Timicasto/HeartRateMonitor/Tex/template_Report.pdf

# 光电心率计

指导教师：吴裕斌
班级：光电 2004 班
姓名：姚海舟∗
学号：U202014528
同组者：汪鑫书 李博函
联系电话：13720213247

2023 年 6 月 1 日

∗Solution chosen by Timicasto Index

1

目录 | 2

目录

1 技术指标 | 4
2 基本原理 | 5
3 方案论证 | 6
4 硬件电路设计 | 7
5 软件设计 | 9
6 测试报告 | 10
7 结论 | 12
8 免责声明 | 12
附录 A 附录 1 - PCB 原理图 | 14
附录 B 附录 2 - PCB 生产版图 | 15
附录 C 附录 3 - BOM 表 | 26

目录 | 3

摘要

基于光电容积描记术（PPG）的光学心率检测系统，该系统由发射器控 制模块，接收器模块，带通滤波模块和信号分析模块组成，脉搏信号依次通 过上述模块处理后得到最终精确的脉搏。

1 技术指标 | 4

## 1 技术指标

实时信号预处理，在每个脉搏产生后立刻可见心室收缩间隔时间，可用 于监测心率不齐等，可处理 30～260bpm 间的脉搏数据
带有谐波的 700kHz/1Ksps 波形显示与记录 一体化透明盖板，带有为提高光效率和采样精度设计的聚光透镜和变 向棱镜二合一的外形

2 基本原理 | 5

## 2 基本原理

本系统使用 PPG （光电容积描记术）完成脉搏信号量测，将光照射进 皮肤，当血流动力发生变化时，就会可预见地散射光。
氧合血红蛋白在可见光范围内有 550nm 和 600nm 两个吸收峰，使用 绿光 LED 将光射入皮肤，则光电二极管上流过的电流曲线即为血流动力的 变化曲线。
反射光强达最大值时即为此处皮肤中动脉搏动即心室收缩的时刻，因 为心率的定义为两次心室收缩的时间间隔，所以记录相邻的两次时刻并计 算其间隔即为此刻的心率

3 方案论证 | 6

## 3 方案论证

PPG 有两个关键的核心过程，就是信号的发射与采集，氧合血红蛋白 的吸收光谱在 400nm 呈现出最高的一个峰，在 550 和 600nm 上有次高的 两个峰。
因为只有在吸收峰上的光才会是被血红蛋白正确吸收，而 400nm 的 LED 灯又太过昏暗，于是这里选用了主波长为 540～560nm 的 LED 灯作 为发射源。
而光电二极管是可以把特定范围波长的光强转化为电流信号的器件，此 处选择可以响应 540～560nm 波长的光电二极管即可最好地接收反射的光 信号.
然而这里接受到的信号是比较微弱的电流信号，还需要使用跨阻放大 器将其转换为电压信号，并使用增益可变的放大器将电压信号放大，来适应 不同的皮肤透射率，不同环境光强，皮肤与传感器不同距离的使用场景。 放大得到的信号还含有皮肤等其它组织反射的恒定光，表现为直流分 量，和大量的被测皮肤运动产生的高频噪声，此处使用带通滤波器将其滤除 后将信号送入 STM32 的 12 位 ADC。
由于此系统需要处理最大达 260bpm 即 4.3Hz 的信号，则为了更好地 还原波形和更好的数据实时性，将 ADC 配置为 12bit 精度和 1Ksps 的采样 率，分别采样 10Hz 以上被滤除的信号和 4.3Hz 以上被滤除的信号，用于波 形显示和心率计算。
[1] [2]

4 硬件电路设计 | 7

## 4 硬件电路设计

对于主控 MCU 的选型，考虑到此系统的运算量不大，在成本和功耗的 考虑下选择了 STM32G0x0 低成本系列 MCU，得益于 G0 系列不需要晶振 的特点，也可以节省板上空间，而此系统中共需要调试接口，屏幕，可变增 益放大器，采集到的心率信号，LED 控制共五组 IO，则选择具有 20 引脚， 成本最低的的 FxP 封装。
由于所有的 IO 全部都是常用嵌入式接口或 GPIO，则选用 G0x0 中最 低端的型号 G030F6P 作为此系统的主控。
MCU 的供电部分，使用具有 3x3 QFN 小封装低成本的 TLV62130 构 造了 2.5MHz 的高效率开关电源输出系统 3.3V 供电，变换器的效率可达 0.89，且仅占用了 3x5mm 的板面积，可输出最大 3A 的电流。 用户界面使用了一块 1.44in，具有 128x128 分辨率，262K 色的普通 TFT-LCD 屏幕和 50cd/m² 的 WLED 背光，配合 ST7735S 控制芯片，使 用五个 IO 接口，分别传输显示数据，显示时钟，重置信号，命令/数据标志 信号和背光信号。
经过对分销商平台上所有 LED 的筛选，最终选择了两颗来自 Vishay 的 VLMTG41S2U1-GS08 ，这颗 LED 使用 InGaN 技术部分攻克了绿光 LED 的亮度难题，在 3.2V 的正向电压下达到了至少 560mcd 的亮度，且波 长偏离不超过 +-15nm。
光电二极管的选型遇到了一点难题，绝大多数光电二极管是设计用来 接收红外遥控信号的，所以完全不会响应可见光。
经历了海量的搜索后，仍然是在 Vishay 找到了我们想要的东西：VEMD5510C， 它的响应峰值波长刚好为 550nm，只响应 440～700nm 之间的光，完全符 合本系统的波长需要。
因为 VEMD5510C 只有 0.2mm 厚，而我们的 LED 却是标准的 3528 封装，有 1.75mm 厚，于是我们把光电二极管夹在了两颗 LED 之间，并在 上面加上了一体式的聚光和变向棱镜。
放大器的部分，因为心率信号的带宽很低，所以为成本考虑选择了双 路 LM2904 运算放大器，并使用 TPS60403 电荷泵作为负压源，使用三颗 LM2904 构造起了跨阻放大器，可变增益放大器和后级的带通滤波器。 VEMD5510C 在 1000 lx 下有 10uA 的电流，于是我们采用了增益为 5dB 的跨阻放大器，将 0～10uA 的信号转换至 0～2.5V，让可变增益放大 器具有更大的操作空间。
在设计可变增益放大器时再次遇到了难点。
市面上的 PGA 芯片都达到了动辄百元的高价，并且增益配置也不够自

4 硬件电路设计 | 8

由，于是我们想到了使用数字电位器作为普通正增益运算放大器的反馈电 阻，本来以为数字电位器不是设计用于做这样的事情的，结果意外地真的找 到了可以用于这种用途的数字电位器：使用 I2C 协议的 AD5272。
于是 PGA 的设计顺理成章，使用 AD5272BCPZ-20 设计了 0～20 倍 放大倍数可变的放大器。
最后一个难题就是滤波器了。
本系统中的有效信号频率介于 0.4～4.3Hz 之间，我们选用了增益曲线 较平缓的二级 Butterworth 滤波器作为高通滤波器，滤除 0.4Hz 以下的信 号，但是这里第二级反馈系统的电容太大了，数值也太离谱了。 先是到了离谱的 80uF，调低了阻断频带衰减率后变成了 20.5uF 和 16uF，取 E6 系列电容的近似值则为 33uF 和 15uF，勉勉强强找到了尺寸 为 0805 的 MLCC 电容，免除了使用大号电解电容的麻烦。 然后用阻断频带为 10Hz 和 4.3Hz 的低通滤波器，分别输出用于波形显 示和用于心率计算的信号给 STM32 的 ADC1 CH0 和 CH1。
整个 PCB 的板框尺寸与屏幕的尺寸一致，使用四个 M2 螺丝和屏幕固 定为一体，其它所有电阻电容均选用 0603 封装的型号。 至此完成了上面的电路原理设计和布局布线后，硬件的设计就全部完 成了

5 软件设计 | 9

## 5 软件设计

软件部分使用现代 C/C++ 语言（C23/C++23），引入 STM32 HAL 库与硬件交互，并完全符合现代 OOP 编程范式。
所有硬件初始化代码使用 STM32CubeMX 生成，构建系统文件基于 STM32CubeMX 生成的 Makefile 修改，使其支持 C++ 的编译和链接。 数据采集部分，我们初始化了一个每秒溢出 1000 次的 Timer，用 TRGO 事件触发 ADC 的采集，每完成一次采集触发中断后开始处理数据，将电压 幅值数据送入心率算法对象。
心率算法类接受电压幅值作为输入，使用一次心率周期进行电压范围 校准后，钳制在校准数据峰值三分之二以上的部分为有效峰值数据区域，同 时维护当前周期最大幅值和其对应的绝对采样次数，当下一次幅值进入有 效峰值窗口时将当前数据记录为上一周期与当前周期作差后计算时间间隔 对应的心率。
当两个周期的数据均有效，并成功计算出心率后，在主循环中将其发送 至屏幕显示。

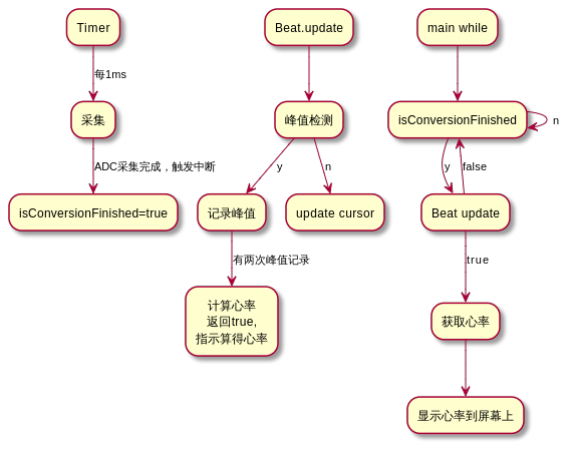
[picture p5: figure]

图 1: 软件设计流程图

6 测试报告 | 10

## 6 测试报告


图 2: 电源纹波测试：5.78mV Peak-to-Peak

6 测试报告 | 11


图 3: 原始电平波形，Y 轴单位长度 0.8mV

7 结论 | 12

## 7 结论

本课程设计报告详细阐述了一个基于光电容积描记术（PPG）的光学心 率检测系统的设计和实现。系统由发射器控制模块，接收器模块，带通滤波 模块和信号分析模块组成，能够实时处理和显示 30 260bpm 间的脉搏数据。 在硬件和软件设计部分，我们选择了 STM32G0x0 低成本系列 MCU 作 为主控，使用了现代 C/C++ 语言（C23/C++23），引入 STM32 HAL 库 与硬件交互。测试结果显示，该系统能够准确地测量和显示心率数据.

## 8 免责声明

此设计不可用于生命攸关的医疗设备，除非已由双方授权官员签署了 专门管控此类使用情况的特殊合同
使用风险自负
This design may not used in life-critical medical equipment unless authorized officers of the parties have executed a special contract specifically governing such use.
USE AT YOUR OWN RISK.

参考文献 | 13

## 参考文献

[1] Doug Mercer. Activity: Heart Rate Monitor Circuit[R].Analog Wiki, 14 May 2022 (https://wiki.analog.com/university/courses/alm1k/alm-lab-heart-rate-mon)
[2] Swagatam. Heart Rate Monitor Circuit[J]. Homemade Circuit Projects, October 18, 2019 (https://www.homemade-circuits.com/heart-rate-monitor-alarm-circuit/)

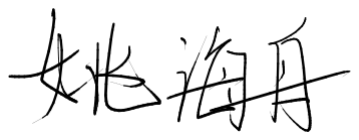
[picture p6: figure]

## A 附录 1 - PCB 原理图

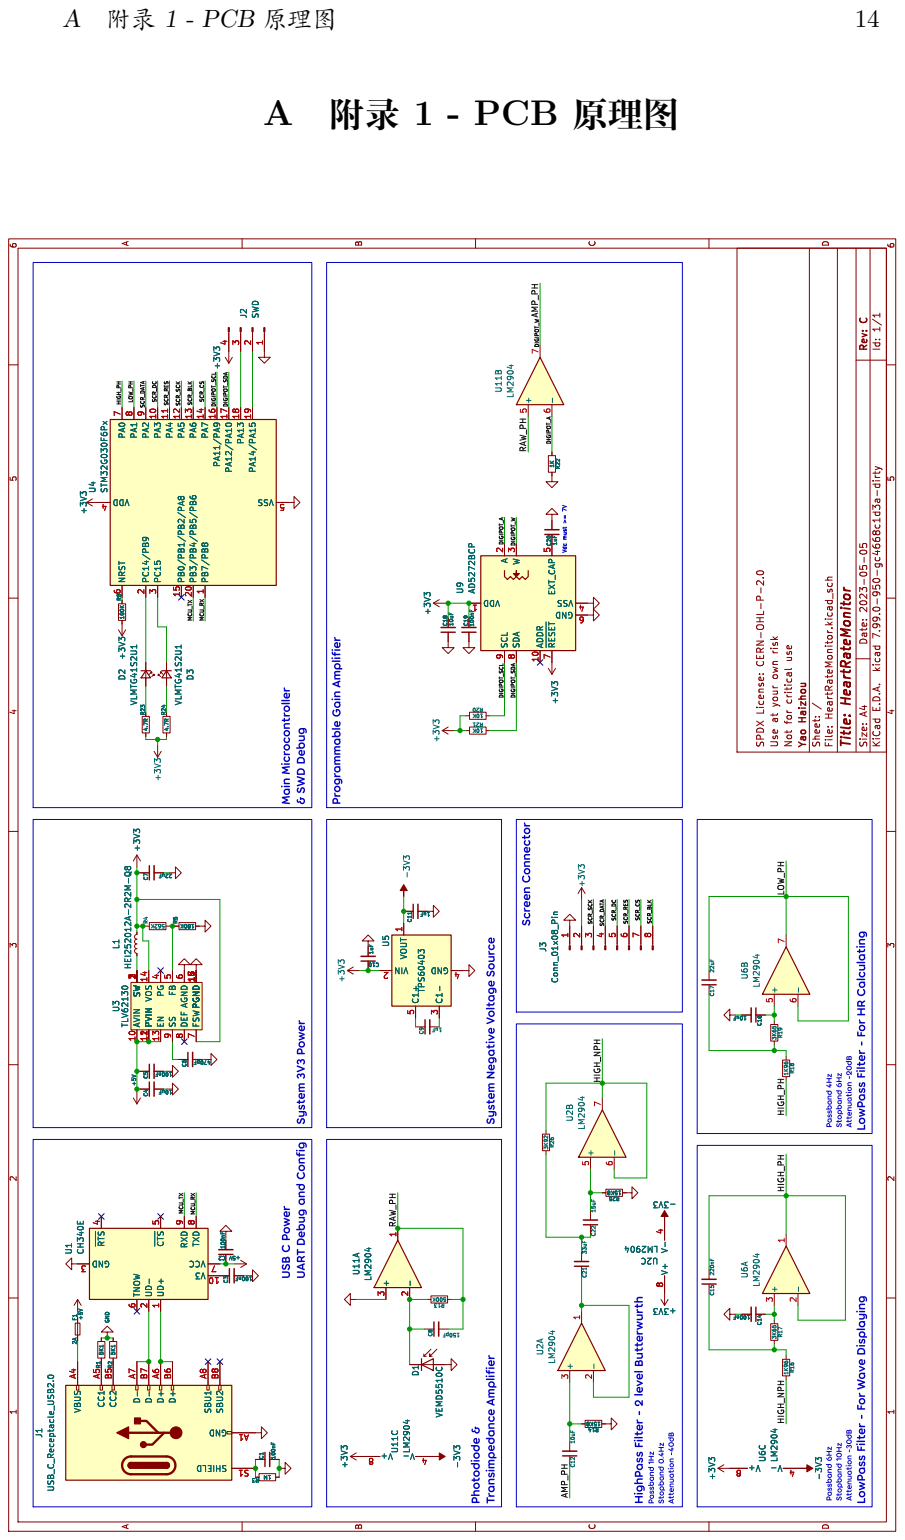
[picture p7: page 14]

D Date: 2023-05-05 KiCad E.D.A. kicad 7.99.0-950-gc4668c1d3a-dirty Rev: C Size: A4

Id: 1/1 Title: HeartRateMonitor File: HeartRateMonitor.kicad_sch Sheet: / Yao Haizhou Not for critical use Use at your own risk SPDX License: CERN-OHL-P-2.0

Vdc must >= 7V System Negative Voltage Source

100nF R5180K C7 22uF U3 TLV62130SW 1 AVIN 10 PVIN 112 EN 13 VOS 14 PGND 1567 SW 23 PG 4 FB 5 AGND 6 FSW 7 DEF 8 SS 9 +3V3

R23 4.7R R4562K SW 1 AVIN 10 PVIN 112 EN 13 VOS 14 PGND 1567 SW 23 PG 4 FB 5 AGND 6 FSW 7 DEF 8 SS 9 U3 TLV62130 +3V3 +3V3 VOUT 1 VIN

HIGH_PH LowPass Filter - For HRCalculating

System 3V3 Power Passband 6Hz Stopband 10Hz Attenuation -30dB

Transimpedance Amplifier Passband 4Hz Stopband 6Hz Attenuation -20dB USBC Power

Passband 1Hz Stopband 0.4Hz Attenuation -40dB HighPass Filter - 2 level Butterwurth+3V3 -3V3U2C LM2904 V- 4 V+ 8 R25 15K8 +5V C4 10uF C5 100nF C2 +5V

+5V GND U1 CH340E UD+ 1 V3 10 UD- 2 GND

LowPass Filter - For Wave Displaying

## B 附录 2 - PCB 生产版图

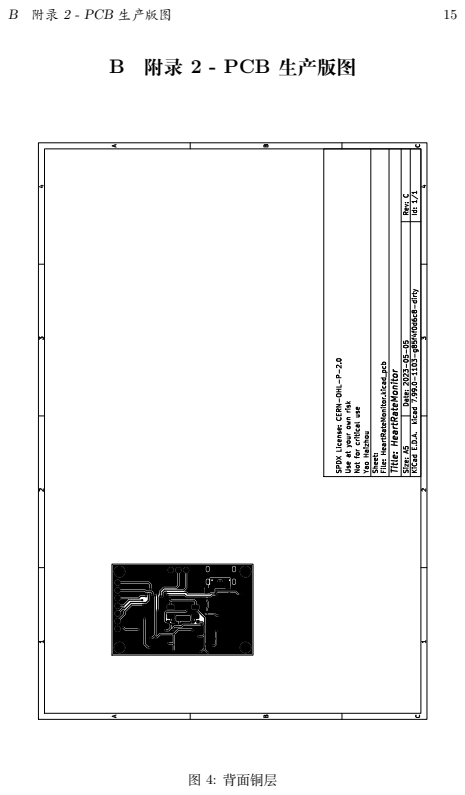
[picture p8: page 15]
B 附录 2 - PCB 生产版图; 图 4: 背面铜层

BC Date: 2023-05-05 KiCad E.D.A. kicad 7.99.0-1103-g85f4f0d6c8-dirty Rev: C Size: A5

Id: 1/1 Title: HeartRateMonitor File: HeartRateMonitor.kicad_pcb Yao Sheet:Haizhou Not for critical use Use at your own risk SPDX License: CERN-OHL-P-2.0

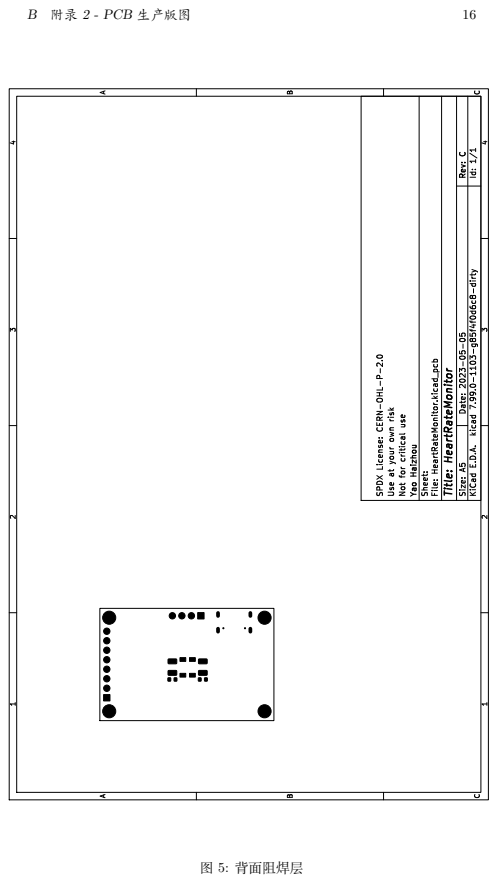
[picture p9: page 16]
B 附录 2 - PCB 生产版图; 图 5: 背面阻焊层

BC Date: 2023-05-05 KiCad E.D.A. kicad 7.99.0-1103-g85f4f0d6c8-dirty Rev: C Size: A5

Id: 1/1 Title: HeartRateMonitor File: HeartRateMonitor.kicad_pcb Yao Sheet:Haizhou Not for critical use Use at your own risk SPDX License: CERN-OHL-P-2.0

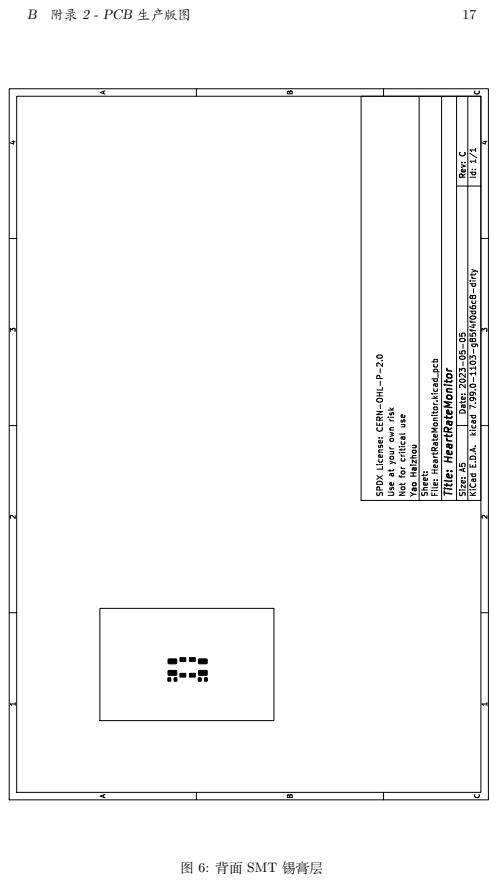
[picture p10: page 17]
B 附录 2 - PCB 生产版图

BC Date: 2023-05-05 KiCad E.D.A. kicad 7.99.0-1103-g85f4f0d6c8-dirty Rev: C Size: A5

Id: 1/1 Title: HeartRateMonitor File: HeartRateMonitor.kicad_pcb Yao Sheet:Haizhou Not for critical use Use at your own risk SPDX License: CERN-OHL-P-2.0

图 6: 背面 SMT 锡膏层

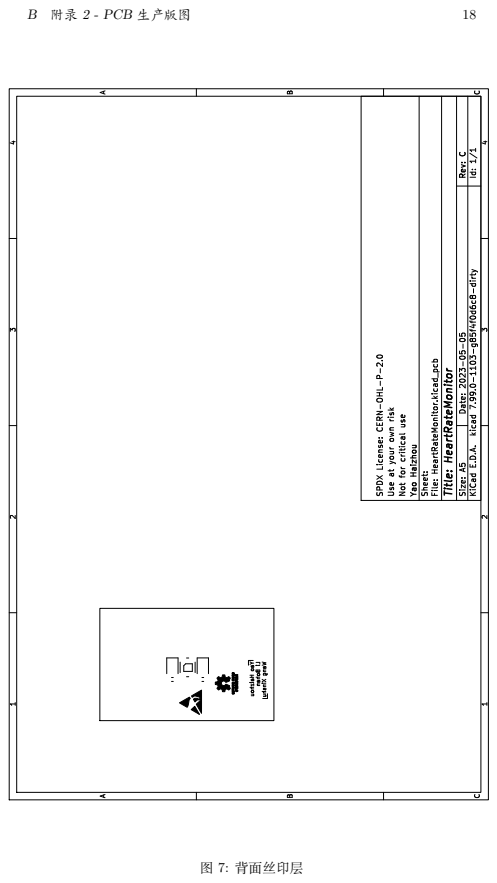
[picture p11: page 18]
B 附录 2 - PCB 生产版图; Yao Haizhou; 图 7: 背面丝印层

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

Li Bohan Wang Xinshu

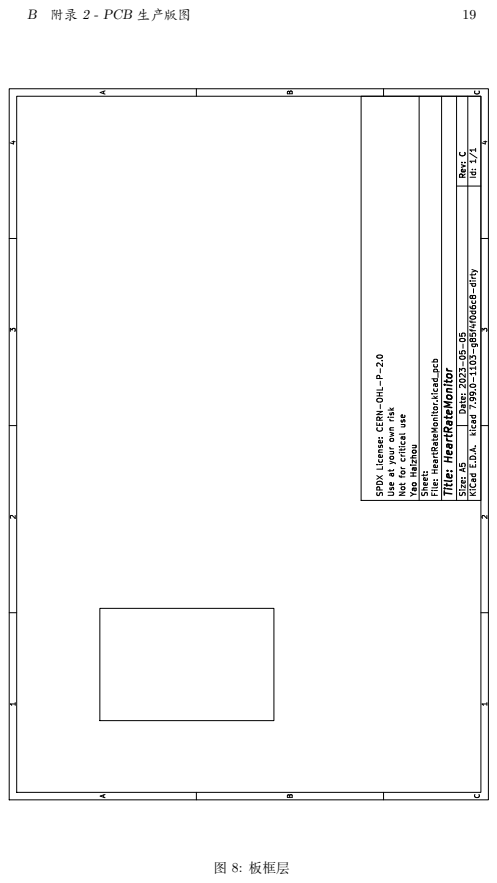
[picture p12: page 19]
B 附录 2 - PCB 生产版图; 图 8: 板框层

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

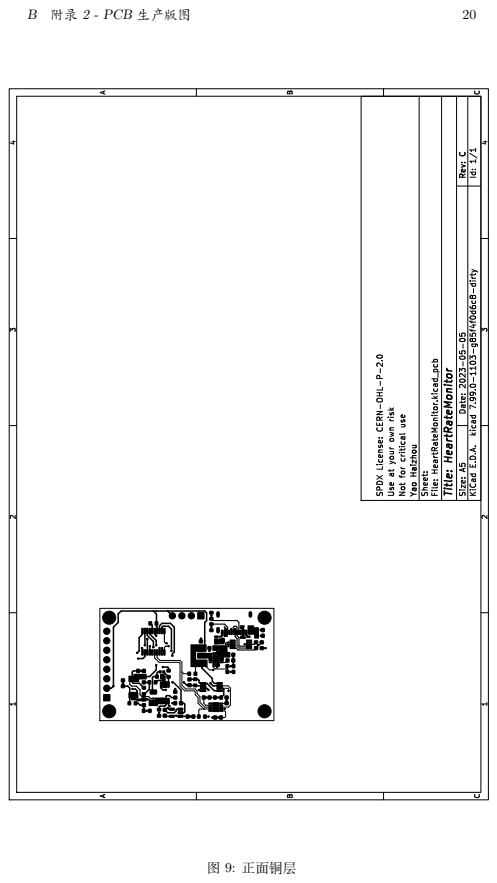
[picture p13: page 20]
B 附录 2 - PCB 生产版图; 图 9: 正面铜层

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

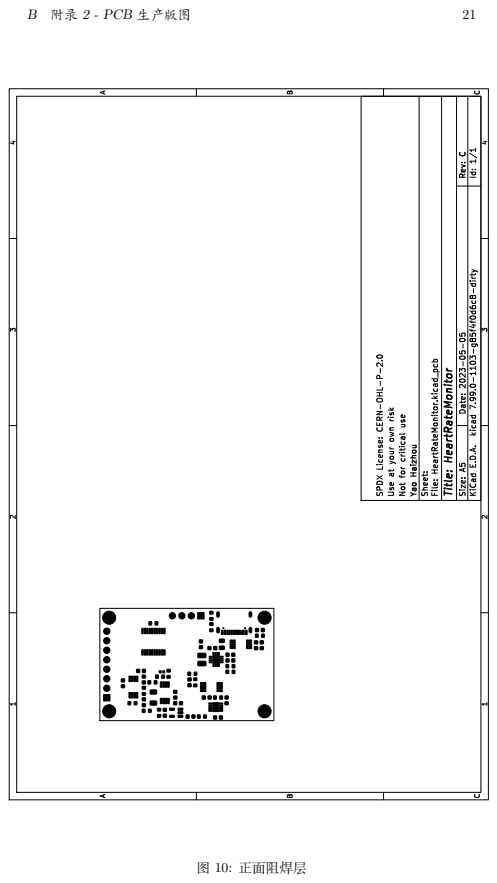
[picture p14: page 21]
B 附录 2 - PCB 生产版图; 图 10: 正面阻焊层

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

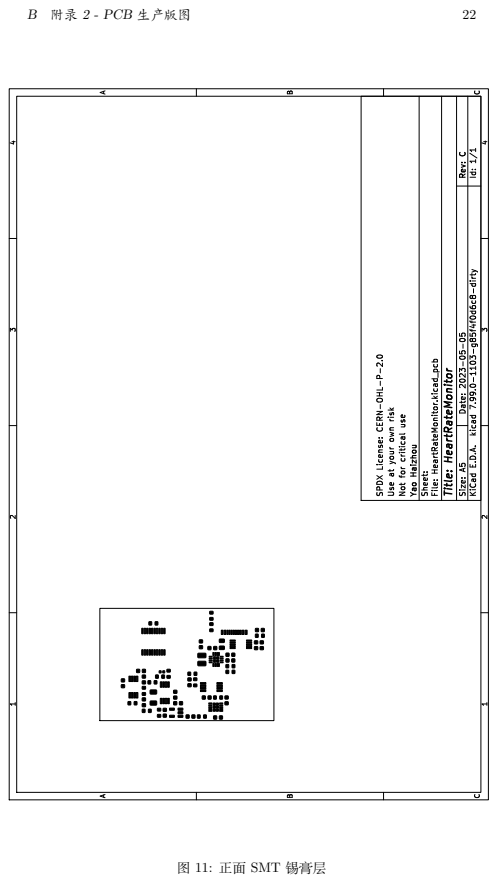
[picture p15: page 22]
B 附录 2 - PCB 生产版图

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

图 11: 正面 SMT 锡膏层

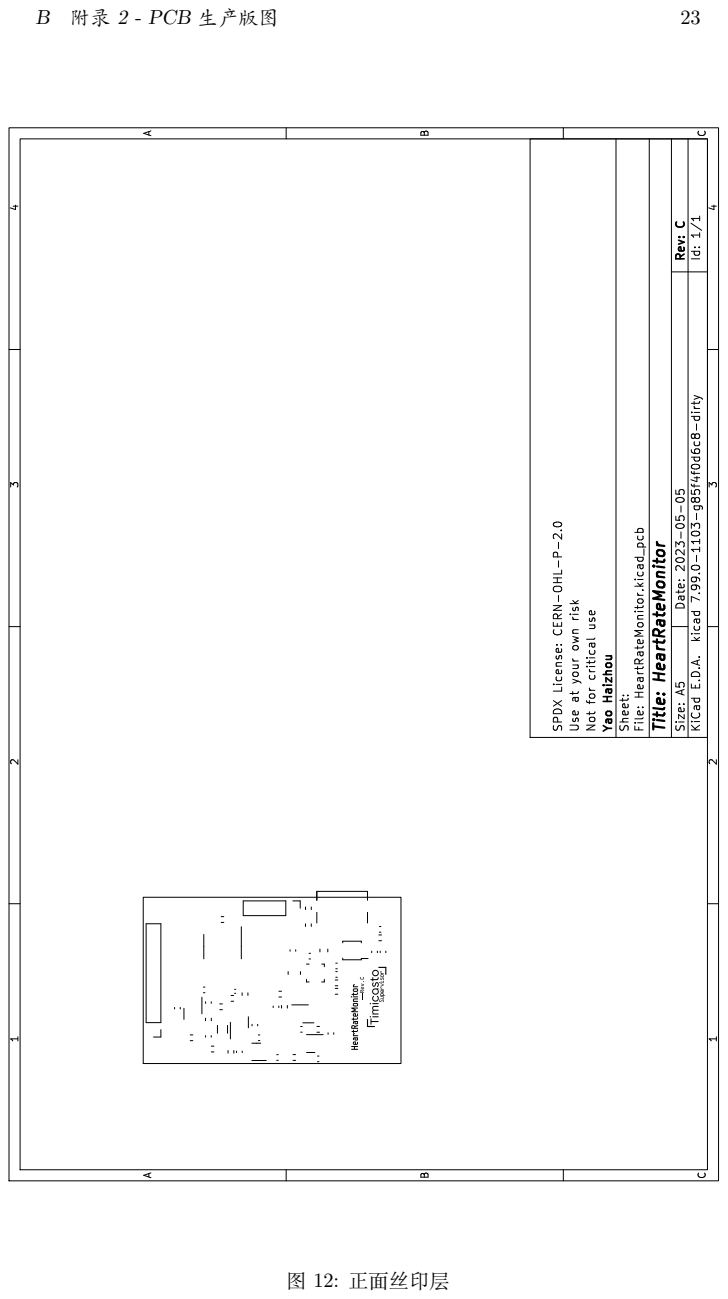
[picture p16: page 23]
B 附录 2 - PCB 生产版图; Supervisor Timicasto; HeartRateMonitor; 图 12: 正面丝印层

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

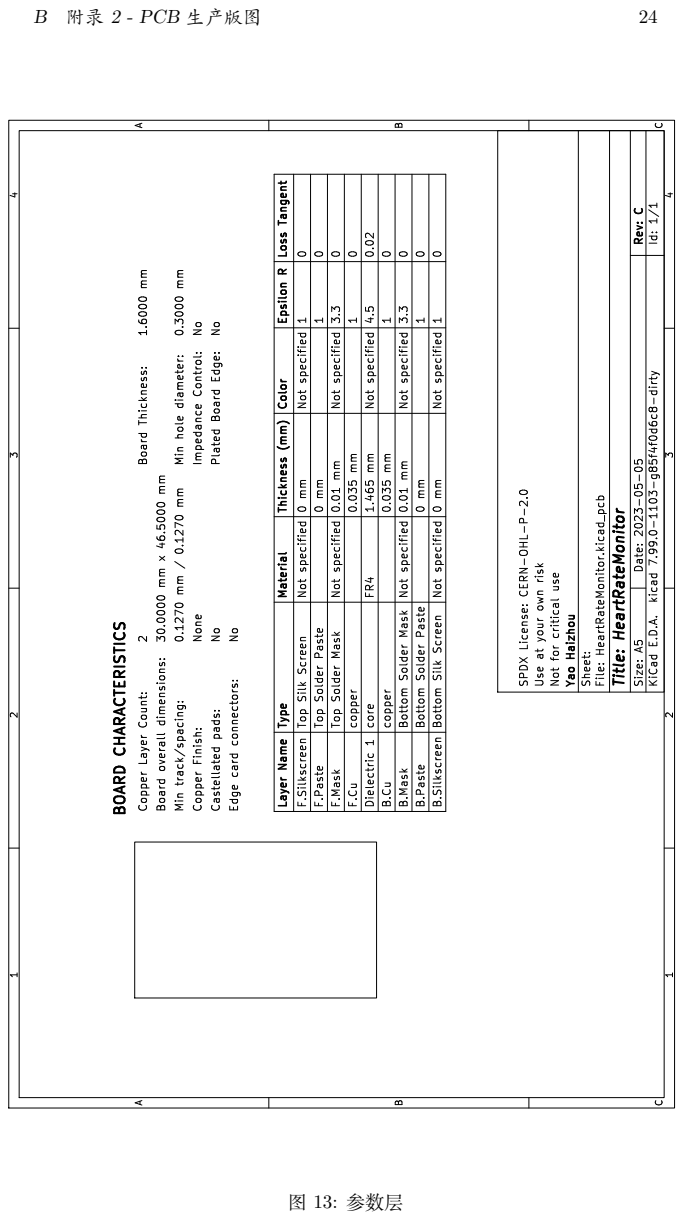
[picture p17: page 24]
B 附录 2 - PCB 生产版图; Not specified; 0 Top; copperSilk Screen; core; 0 Not specified; Color No; 图 13: 参数层

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

Loss Tangent Bottom Solder Paste

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

Dielectric 1 Min track/spacing: 4.5 Material 0.02 Not specified

0 Board overall dimensions: 0 mm

0 F.Cu Castellated pads:

0 Not specified F.Silkscreen Top Solder Mask Thickness (mm) Not specified

1 Not specified B.Silkscreen Epsilon R

Impedance Control: Bottom Solder Mask 1.6000 mm

3.3 Copper Finish: Min hole diameter: copper 0.3000 mm

1 Board Thickness: Bottom Silk Screen 0 mm

Edge card connectors: 1 None

Layer Name No

F.Mask Plated Board Edge: B.Mask 0.035 mm

0.035 mm BOARD CHARACTERISTICS

Copper Layer Count: Not specified F.Paste

Not specified Not specified B.Paste Type

Top Solder Paste

C 附录 3 - BOM 表 | 25

## C 附录 3 - BOM 表

Ref | Qnty | Value | Cmp name
C1 C2 C3 C5 C14 C19 | 6 | 100nF | TCC0603X7R104M160CT
C4 C12 C16 C18 | 4 | 10uF | CL10A106MQ8NNNC
C6 | 1 | 470pF | CC0603KRX7R9BB471
C7 C17 | 2 | 22uF | GRM188R61A226ME15D
C8 | 1 | 150pF | TCC0603X7R151K500CT
C9 C10 C11 C20 | 4 | 1uF | CL10A105KO8NNNC
C15 | 1 | 220nF | CS1608Y5V224Z160NRB
C21 | 1 | 33uF | C3216X5R1A336MTJ00N
C22 | 1 | 15uF | GRM155R60J156ME05D
D1 | 1 | VEMD5510C | VEMD5510C
D2 D3 | 2 | VLMTG41S2U1 | VLMTG41S2U1
F1 | 1 | 2A | SMD0805-100C-12V
J1 | 1 | USB-C-Receptacle-USB2.0 | USB-TYPE-C-019
J2 | 1 | SWD | Conn-01x04-Pin
J3 | 1 | Conn-01x08-Pin | 22850108ANG1SYA01
L1 | 1 | HEI252012A-2R2M-Q8 | HEI252012A-2R2M-Q8
R1 R2 | 2 | 5K1 | SCR0603F5K1
R3 | 1 | 1M | SC0603F1004F2BNRH
R4 | 1 | 562K | FRC0603F5623TS
R5 | 1 | 180K | SCR0603F180K
R8 | 1 | 100K | SCR0603F100K
R13 | 1 | 500K | ARG03BTC5003N
R14 R25 | 2 | 15K8 | FRC0603F1582TS
R16 R18 | 2 | 1K96 | FRC0603F1961TS
R17 R19 | 2 | 3K65 | FRC0603F3651TS
R20 R21 | 2 | 10K | SC0603F1002F2BNRH
R22 | 1 | 1K | 0603WAF1001T5E
R23 R24 | 2 | 4.7R | FRC0603F4R70TS
R26 | 1 | 3K92 | 0603WAF3921T5E
U1 | 1 | CH340E | CH340E
U2 U6 U11 | 3 | LM2904 | LM2904DGKR
U3 | 1 | TLV62130 | TLV62130RGTR
U4 | 1 | STM32G030F6Px | STM32G030F6P6
U5 | 1 | TPS60403 | TPS60403DBVR
U9 | 1 | AD5272BCP | AD5272BCPZ-20
