Timicasto/HeartRateMonitor/Tex/truetable.tex

\documentclass[a4paper]{ctexart}
\usepackage{CJK}
\usepackage{graphicx}
\usepackage{longtable}
\usepackage{float}
\usepackage{subfigure}
\usepackage{hyperref}
\begin{document}

	\newpage
	\begin{longtable}{p{1cm}|p{2cm}|p{2cm}|p{2cm}|P{2cm}|p{2cm}}
		采样次数 & 上一次心搏的电平峰值 & 上一次心搏时间 & 本次心搏峰值 & 本次心搏时间 & 两次心搏间隔 \\
		\hline
		1&0&0&0&0&0\\
		2&0&0&0&1&0\\
		3&0&0&0&2&0\\
		4&0&0&0&3&0\\
		5&0&0&0&4&0\\
		6&0&0&0&5&0\\
		7&0&0&0&6&0\\
		8&0&0&0&7&0\\
		9&0&0&0&8&0\\
		10&0&0&0&9&0\\
		11&0&0&0&10&0\\
		12&0&0&0&11&0\\
		13&0&0&0&12&0\\
		14&0&0&0&13&0\\
		15&0&0&0&14&0\\
		16&0&0&0&15&0\\
		17&0&0&0&16&0\\
		18&0&0&0&16&0\\
		19&0&0&0&16&0\\
		20&0&0&0&16&0\\
		21&0&0&0&16&0\\
		22&0&0&0&16&0\\
		23&0&0&0&16&0\\
		24&0&0&0&16&0\\
		25&0&0&0&16&0\\
		26&0&0&0&16&0\\
		27&0&0&0&16&0\\
		28&0&0&0&16&0\\
		29&0&0&0&16&0\\
		30&0&0&0&16&0\\
		31&0&0&0&16&0\\
		32&0&0&0&16&0\\
		33&0&0&0&16&0\\
		34&0&0&0&16&0\\
		35&0&0&0&16&0\\
		36&0&0&0&16&0\\
		37&0&0&0&16&0\\
		38&0&0&0&16&0\\
		39&0&0&0&16&0\\
		40&0&0&0&16&0\\
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
		
		\caption{上图波形输入算法的真值表}
	\end{longtable}
\end{document}
