Timicasto/HeartRateMonitor/Tex/truetable.pdf

1

采 样
次数

上一次心搏
的电平峰值

上一次心搏
时间

本次心搏峰
值

本次心搏时间 两次心搏间隔

1 | 0 | 0 | 0 | 0 | 0
2 | 0 | 0 | 0 | 1 | 0
3 | 0 | 0 | 0 | 2 | 0
4 | 0 | 0 | 0 | 3 | 0
5 | 0 | 0 | 0 | 4 | 0
6 | 0 | 0 | 0 | 5 | 0
7 | 0 | 0 | 0 | 6 | 0
8 | 0 | 0 | 0 | 7 | 0
9 | 0 | 0 | 0 | 8 | 0
10 | 0 | 0 | 0 | 9 | 0
11 | 0 | 0 | 0 | 10 | 0
12 | 0 | 0 | 0 | 11 | 0
13 | 0 | 0 | 0 | 12 | 0
14 | 0 | 0 | 0 | 13 | 0
15 | 0 | 0 | 0 | 14 | 0
16 | 0 | 0 | 0 | 15 | 0
17 | 0 | 0 | 0 | 16 | 0
18 | 0 | 0 | 0 | 16 | 0
19 | 0 | 0 | 0 | 16 | 0
20 | 0 | 0 | 0 | 16 | 0
21 | 0 | 0 | 0 | 16 | 0
22 | 0 | 0 | 0 | 16 | 0
23 | 0 | 0 | 0 | 16 | 0
24 | 0 | 0 | 0 | 16 | 0
25 | 0 | 0 | 0 | 16 | 0
26 | 0 | 0 | 0 | 16 | 0
27 | 0 | 0 | 0 | 16 | 0
28 | 0 | 0 | 0 | 16 | 0
29 | 0 | 0 | 0 | 16 | 0
30 | 0 | 0 | 0 | 16 | 0
31 | 0 | 0 | 0 | 16 | 0
32 | 0 | 0 | 0 | 16 | 0
33 | 0 | 0 | 0 | 16 | 0
34 | 0 | 0 | 0 | 16 | 0

2

35

0

0

| 0 | 16

0
36

0

0 | 0 | 16

0
37

0

0 | 0 | 16

0
38

0

0 | 0 | 16

0
39

0

0 | 0 | 16

0
40

0

0 | 0 | 16

0
41

0

0 | 0 | 16

0
42

0

0 | 0 | 16

0
43

0

0 | 0 | 16

0
44

0

0 | 0 | 16

0
45

0

0 | 0 | 16

0
46

0

0 | 0 | 16

0
47

0

0 | 0 | 16

0
48

0

0 | 0 | 16

0
49

0

0 | 0 | 16

0
50

0

0 | 0 | 16

0
51

0

0 | 0 | 16

0
52

0

0 | 0 | 16

0
53

0

0 | 0 | 16

0
54

0

0 | 0 | 16

0
55

0

0 | 0 | 16

0
56

0

0 | 0 | 16

0
57

0

0 | 0 | 16

0
58

0

0 | 0 | 16

0
59

0

0 | 0 | 16
0
60

0

0 | 41 | 59

0
61

0

0 | 41 | 59

0
62

0

0 | 41 | 59

0
63

0

0 | 41 | 59

0
64

0

0 | 41 | 59

0
65

0
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
1818 | 0 | 1534 | 0 | 1534 | 684
1819 | 0 | 1534 | 0 | 1534 | 684
1820 | 0 | 1534 | 0 | 1534 | 684
1821 | 0 | 1534 | 0 | 1534 | 684
1822 | 0 | 1534 | 0 | 1534 | 684
1823 | 0 | 1534 | 0 | 1534 | 684
1824 | 0 | 1534 | 0 | 1534 | 684
1825 | 0 | 1534 | 0 | 1534 | 684
表 1: 上图波形输入算法的真值表
