Timicasto/HeartRateMonitor/Shell/shell-PartCap.stl

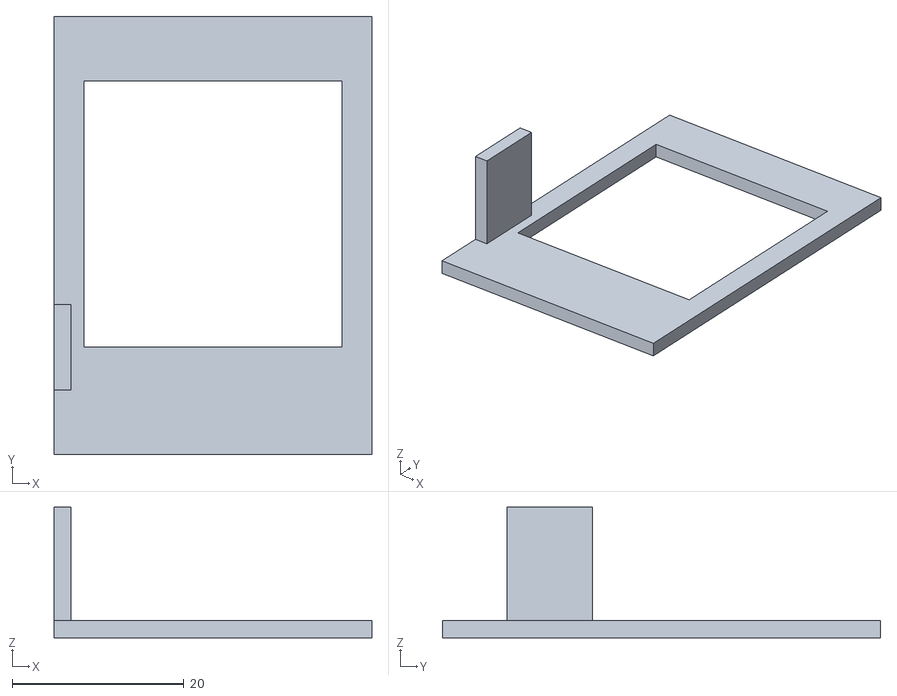
[picture p18: CAD file, 2023-05-20]
Shell/shell-PartCap.stl
37.0 x 51.0 x 15.2
