Timicasto/HeartRateMonitor/Shell/shell-PartBody.stl

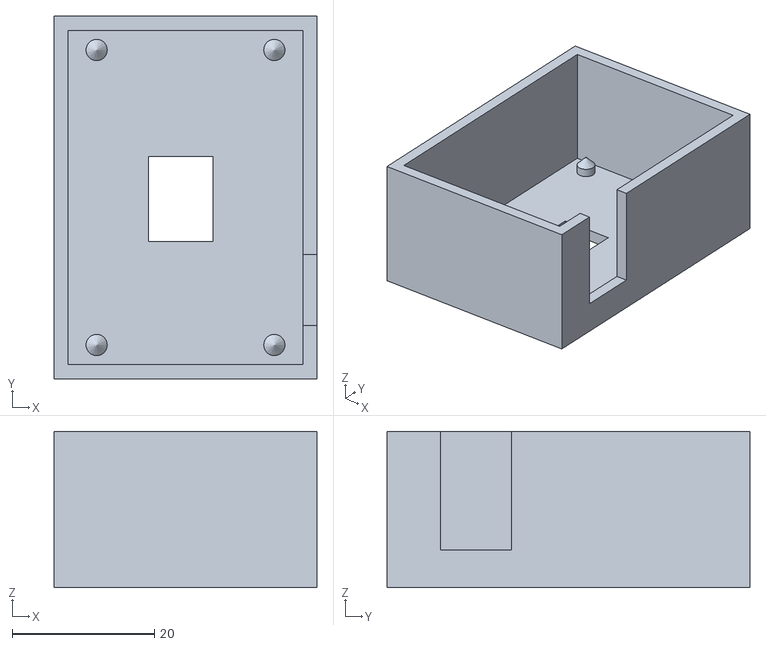
[picture p19: CAD file, 2023-05-20]
Shell/shell-PartBody.stl
37.0 x 51.0 x 22.0
