Timicasto/HeartRateMonitor/Shell/shell.FCStd

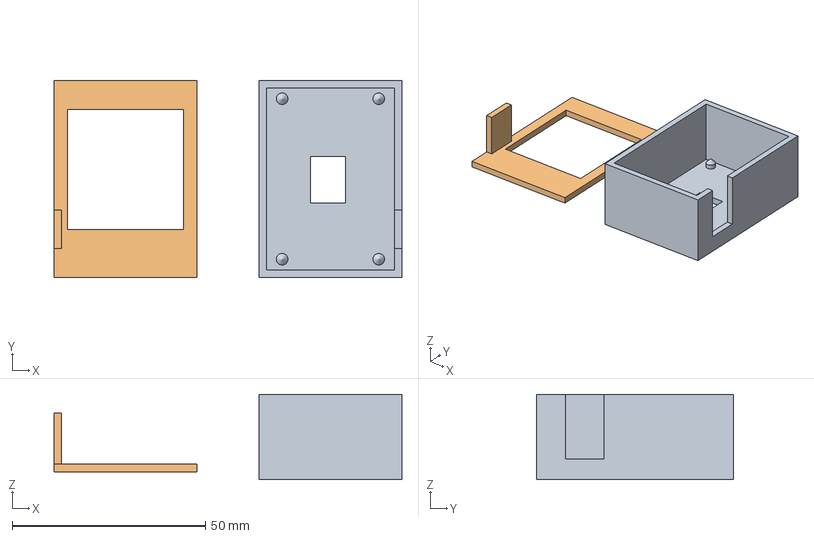
[picture p20: CAD file, 2023-05-20]
Shell/shell.FCStd
90.0 x 51.0 x 22.0 mm
