Timicasto/HeartRateMonitor/PDF/HeartRateMonitor-User_1.pdf

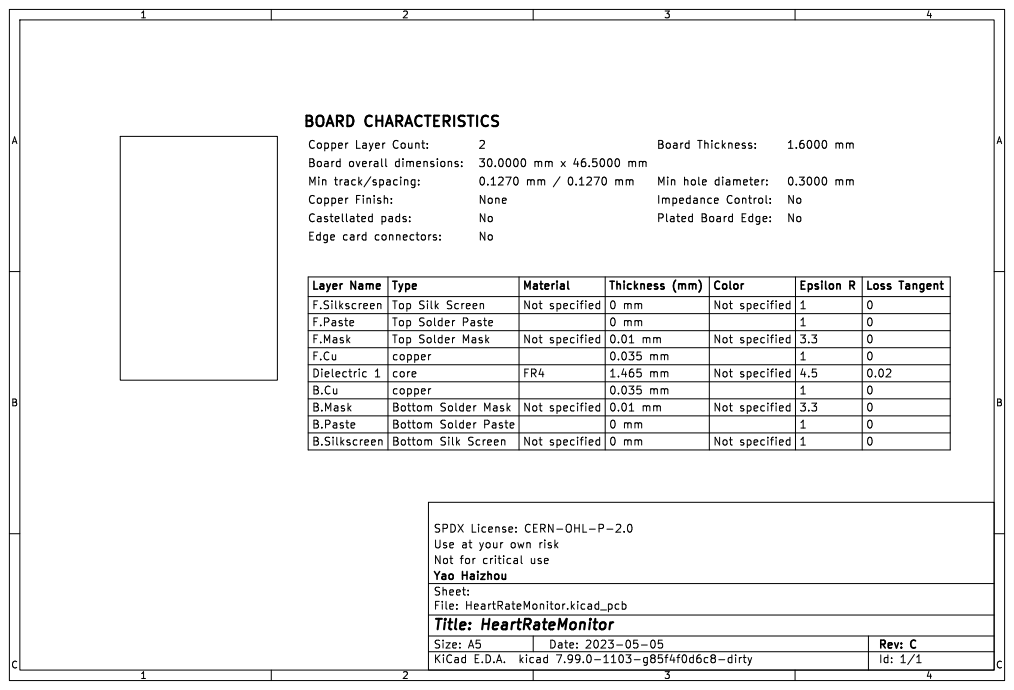
[picture p21: page 1]

F.Mask | pads: | | 0.035 mm | Plated Board | Edge: B.Mask | 3.3 No B.Cu Epsilon R | 0 F.Cu Castellated

Not specified Not specified B.Paste

core Type copper Top Silk Top Solder Paste | Screen | | | | | 1 | 0

0.01 mm | Loss Tangent Bottom Solder Paste 0

0.01 | mm | Not specified | 0

0 mm | Not specified | 1 B.Silkscreen | 0
