Timicasto/HeartRateMonitor/Tex/schem.pdf

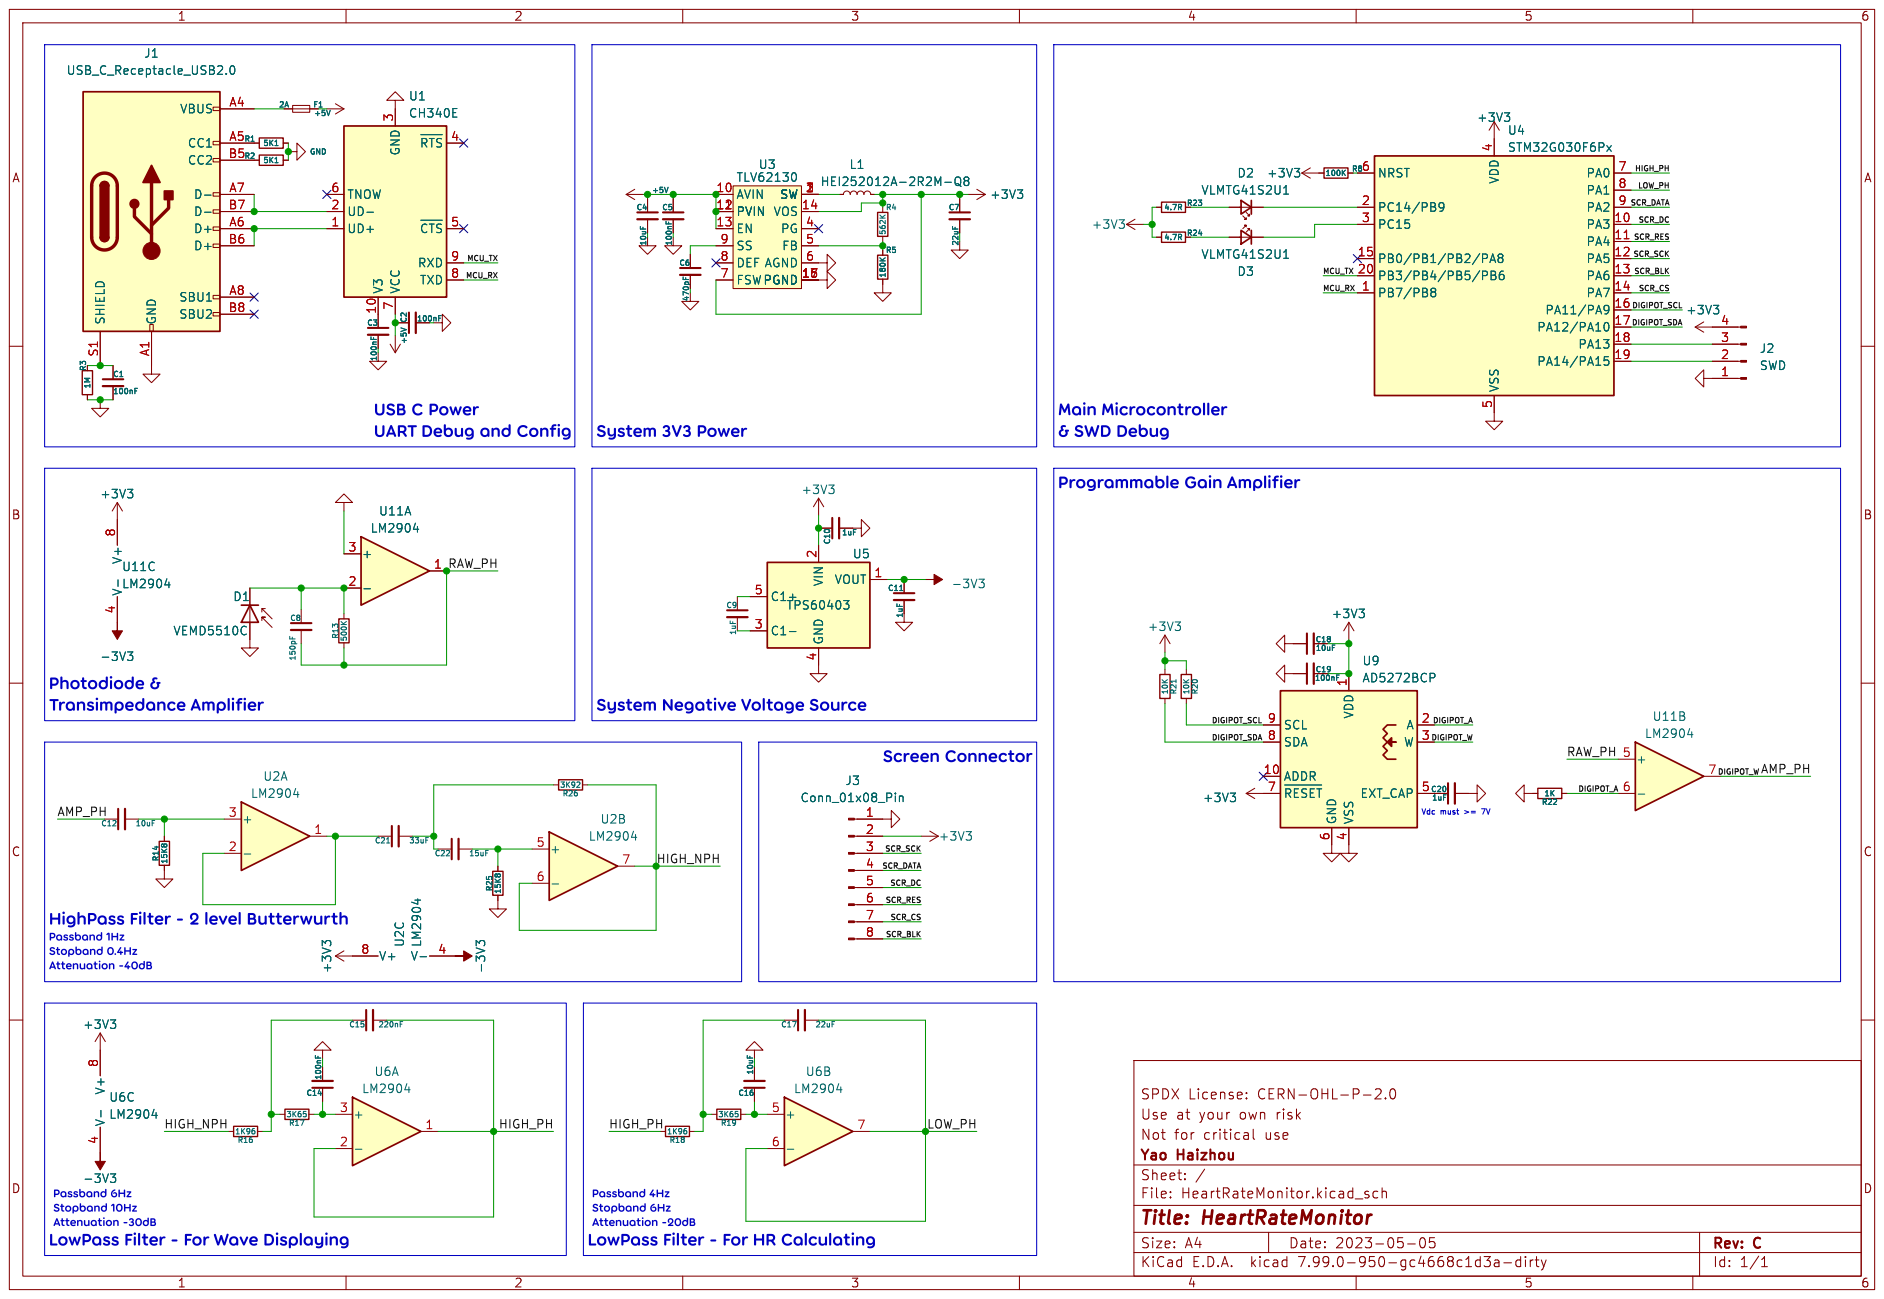
[picture p22: page 1]

3 ~{RTS}4 ~{CTS}5 TNOW 6 VCC

System 3V3 Power Passband 6Hz Stopband 10Hz Attenuation -30dB

Vdc must >= 7V System Negative Voltage Source

LowPass Filter - For Wave Displaying
