Timicasto/HeartRateMonitor/PDF/HeartRateMonitor-B_Cu.pdf

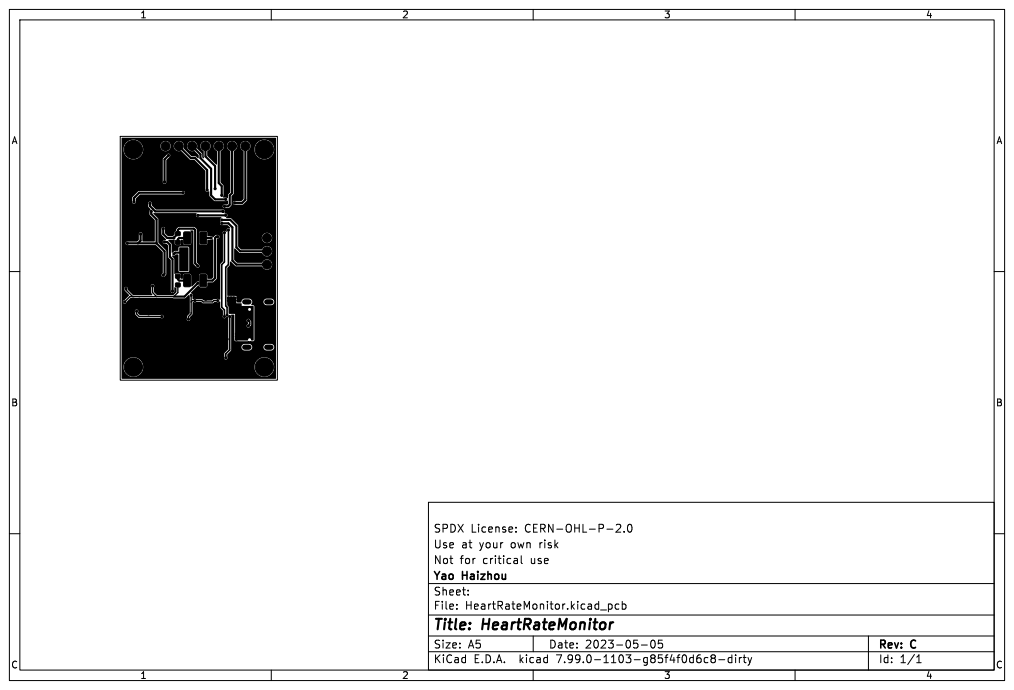
[picture p23: page 1]
