Timicasto/HeartRateMonitor/PDF/HeartRateMonitor-B_Mask.pdf

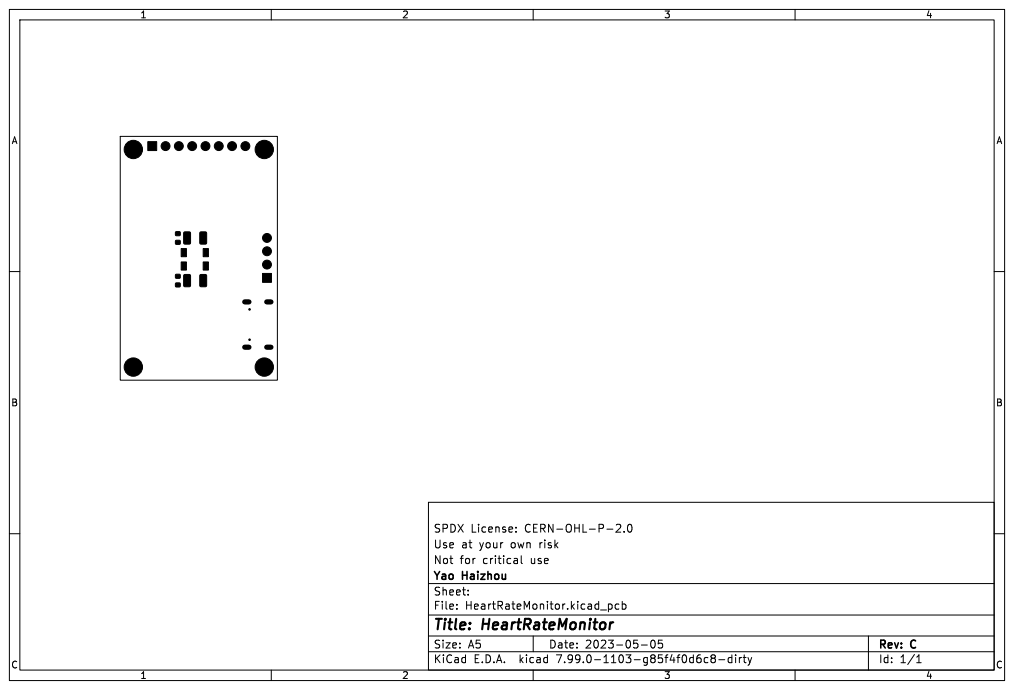
[picture p24: page 1]
