Timicasto/HeartRateMonitor/PDF/HeartRateMonitor-B_Paste.pdf

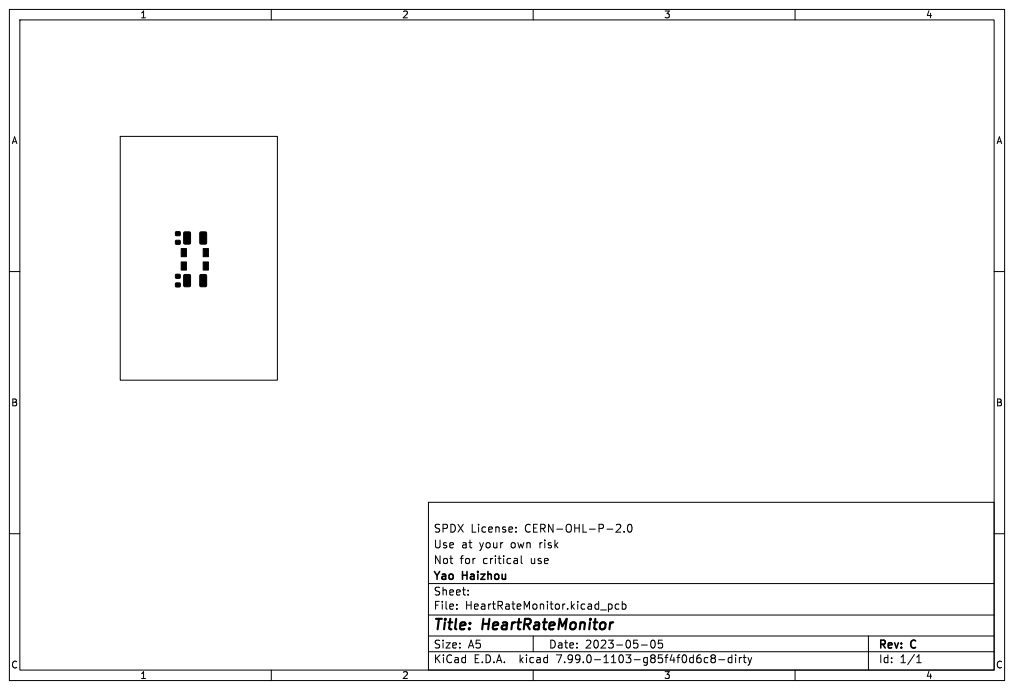
[picture p25: page 1]
