Timicasto/HeartRateMonitor/PDF/HeartRateMonitor-B_Silkscreen.pdf

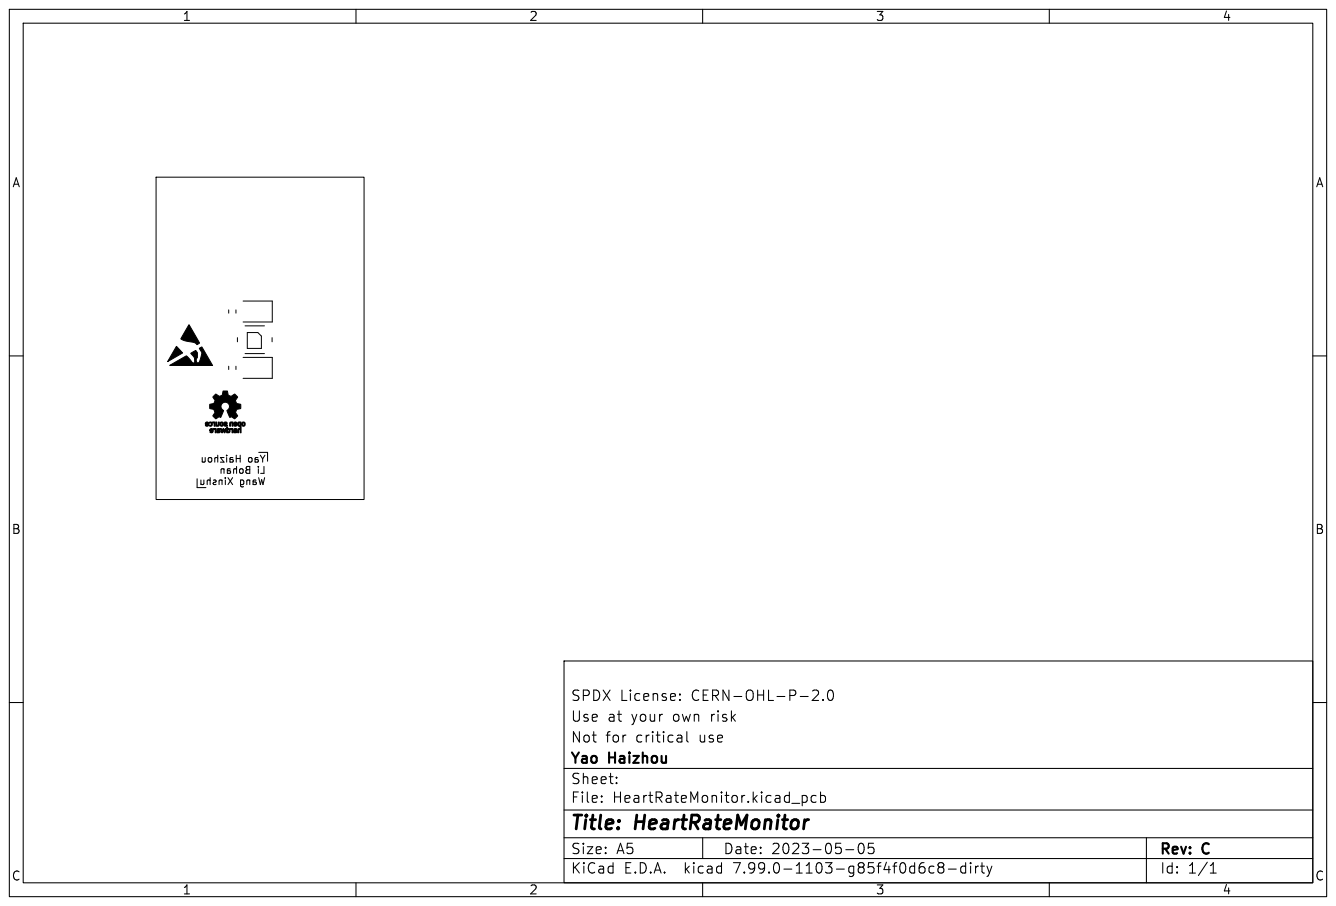
[picture p26: page 1]

Yao Haizhou
Li Bohan Wang Xinshu
