Timicasto/HeartRateMonitor/PDF/HeartRateMonitor-Edge_Cuts.pdf

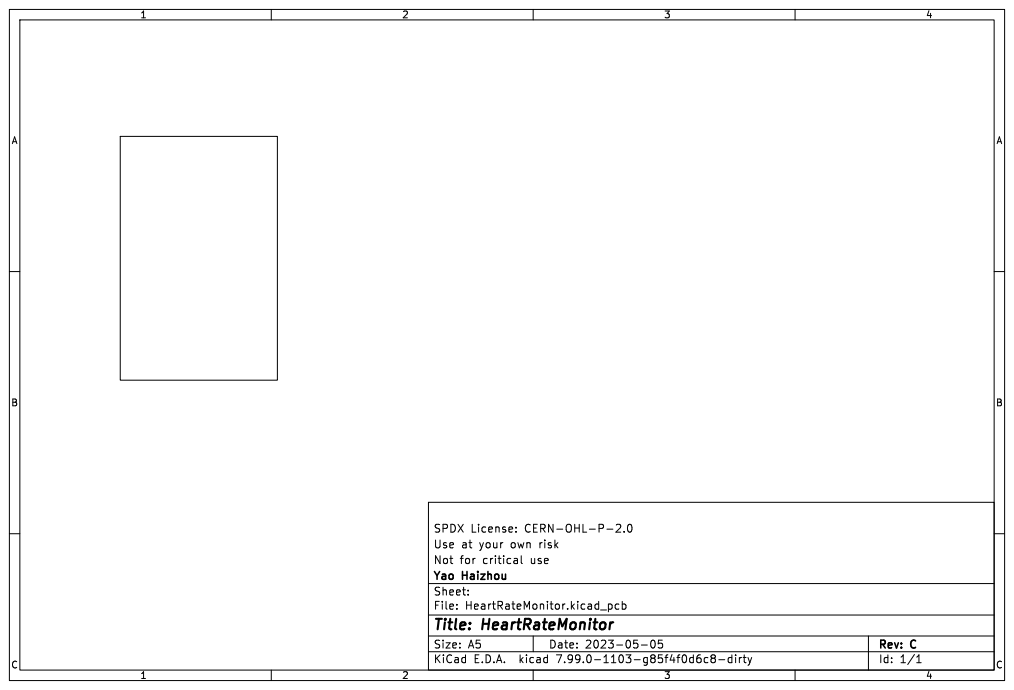
[picture p27: page 1]
