Timicasto/HeartRateMonitor/PDF/HeartRateMonitor-F_Cu.pdf

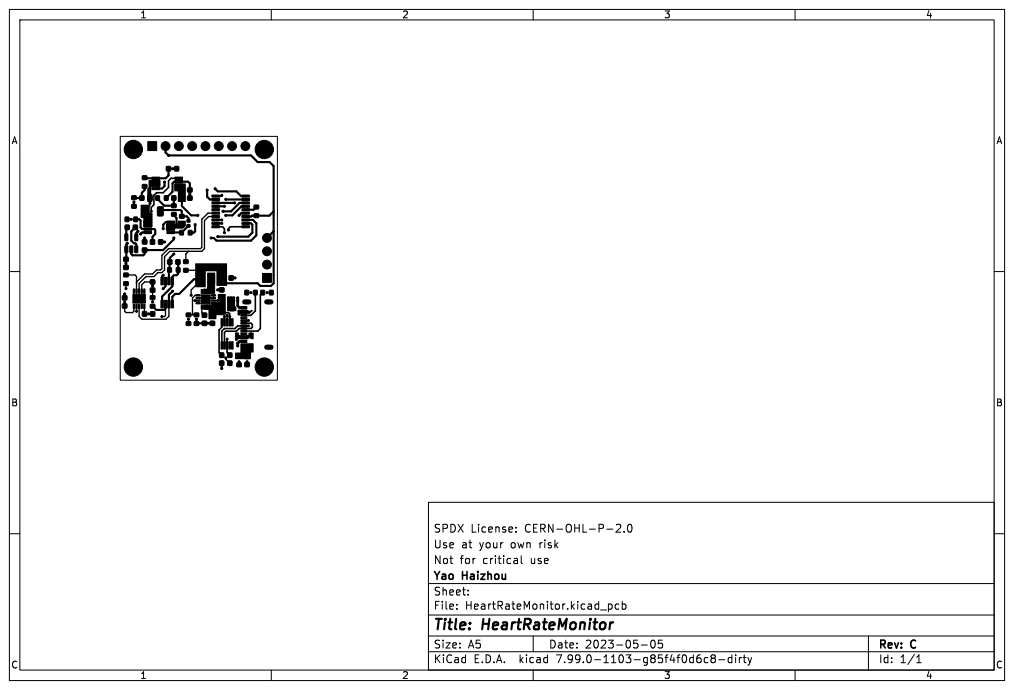
[picture p28: page 1]
