Timicasto/HeartRateMonitor/PDF/HeartRateMonitor-F_Mask.pdf

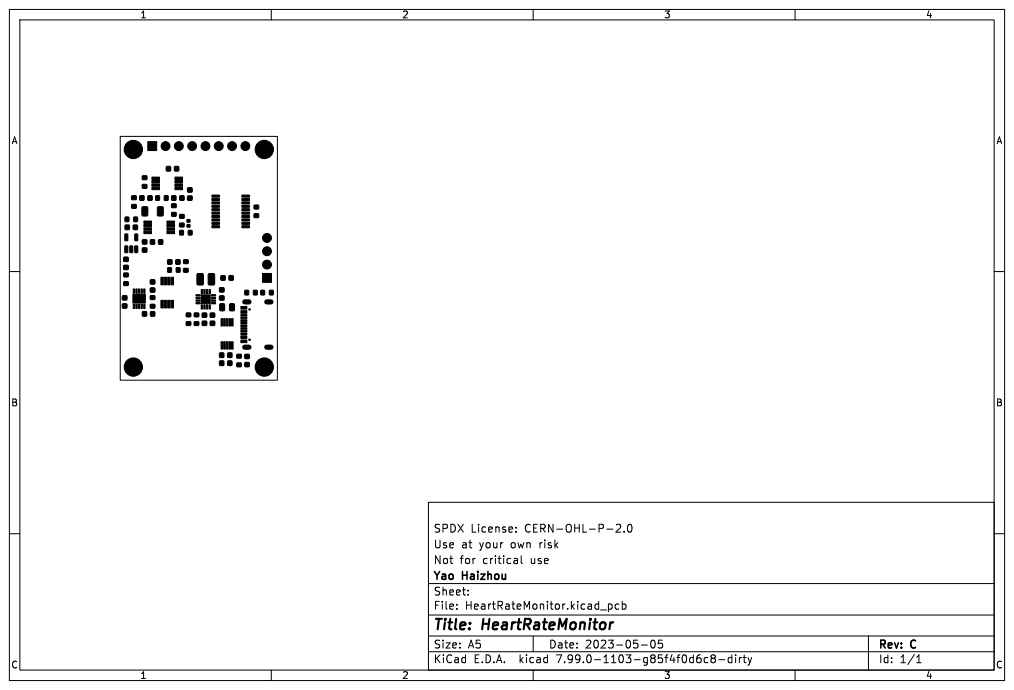
[picture p29: page 1]
