Timicasto/HeartRateMonitor/PDF/HeartRateMonitor-F_Paste.pdf

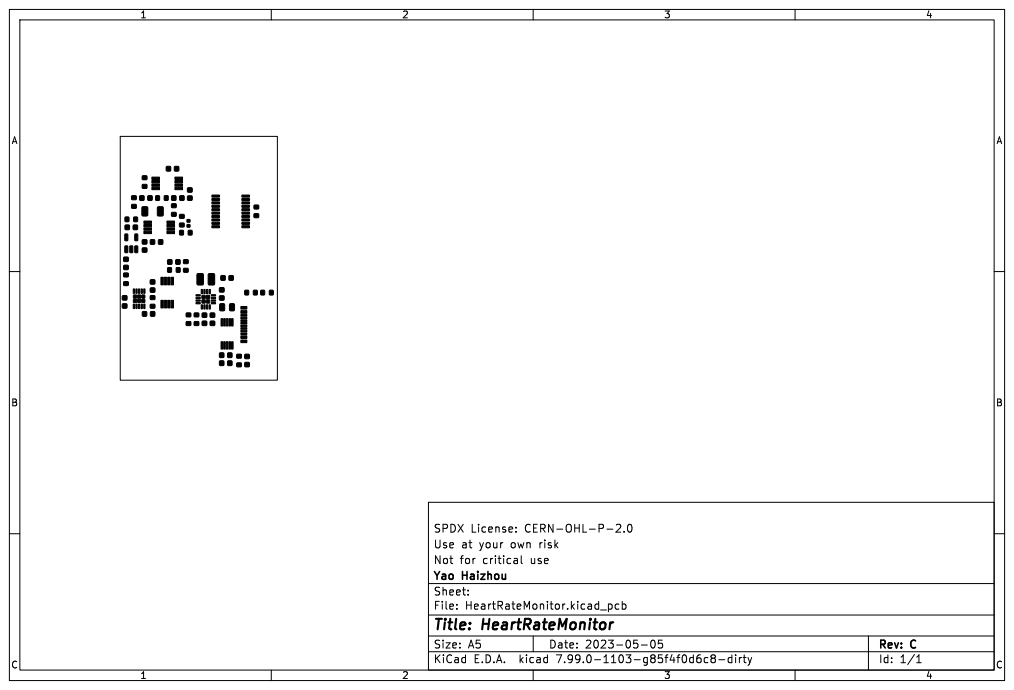
[picture p30: page 1]
