Timicasto/HeartRateMonitor/PDF/HeartRateMonitor-F_Silkscreen.pdf

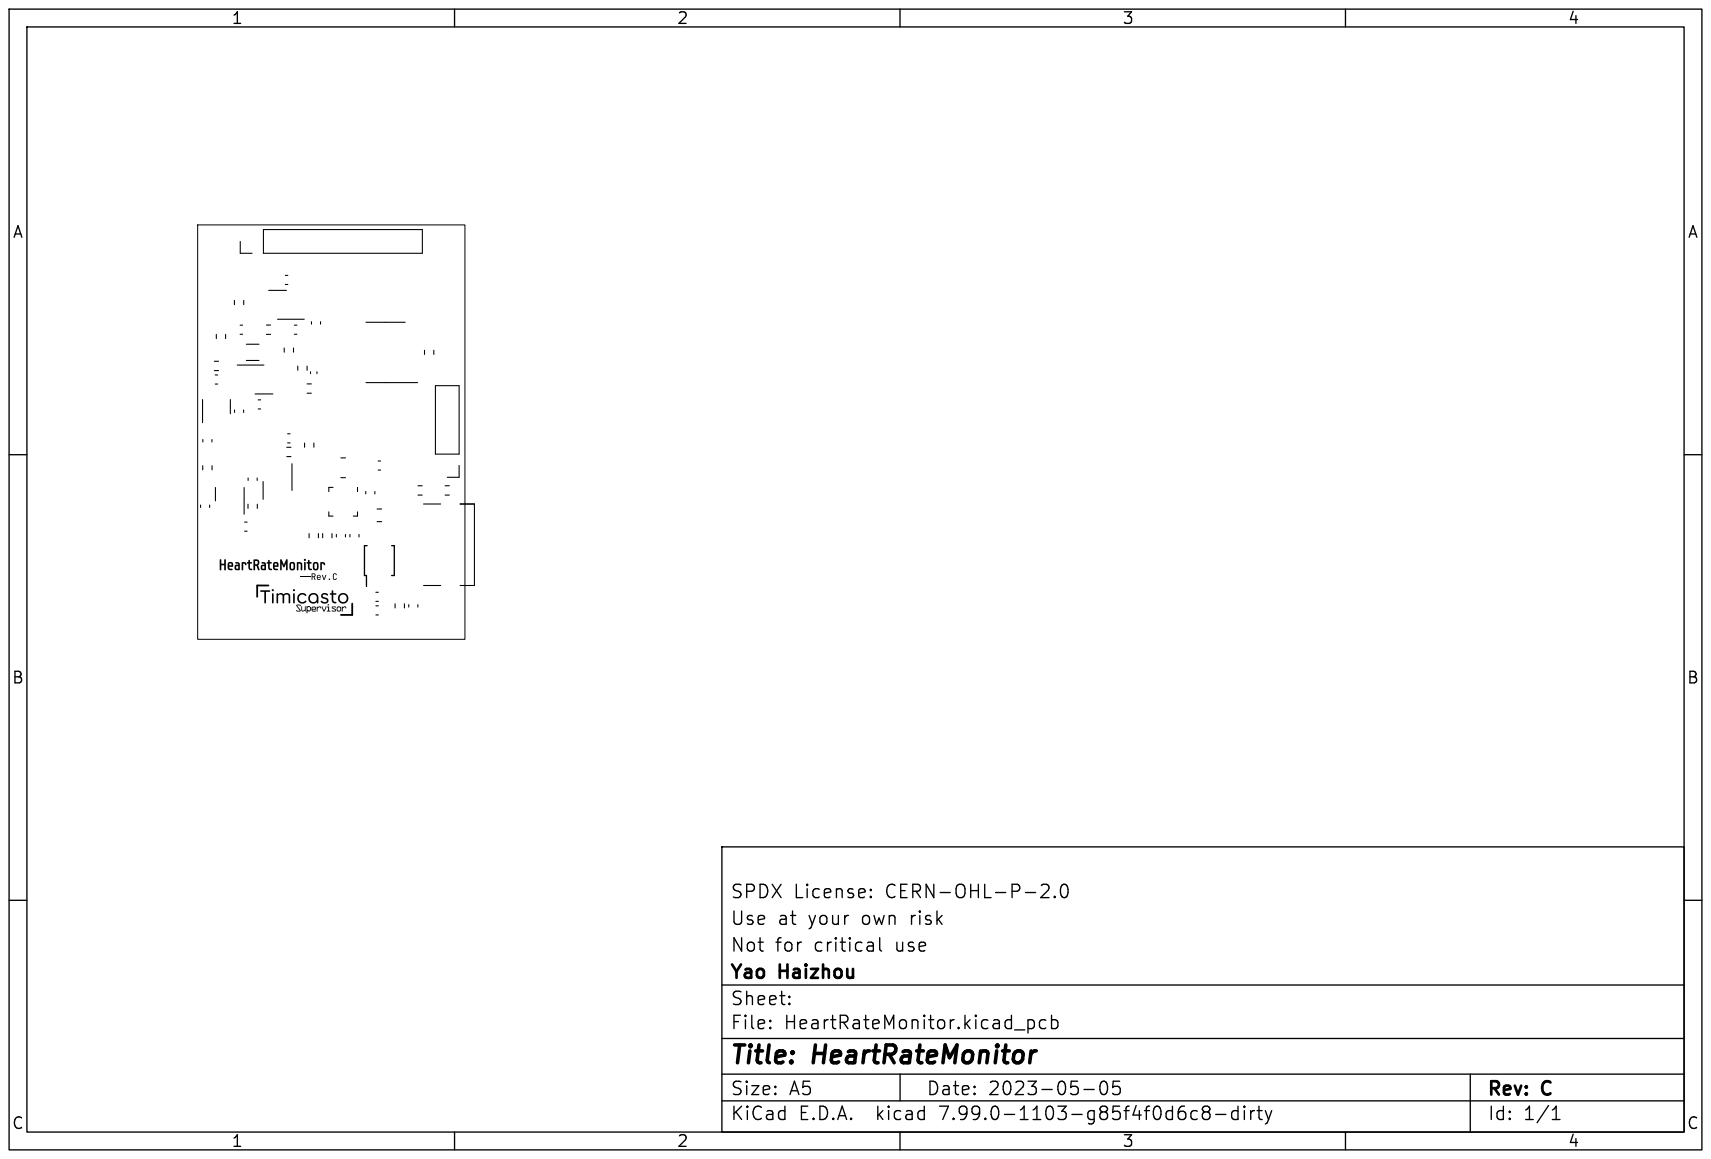
[picture p31: page 1]
