Timicasto/HeartRateMonitor/HeartRateMonitor.kicad_pcb

## KiCad design HeartRateMonitor.kicad_pcb (2023-05-31)

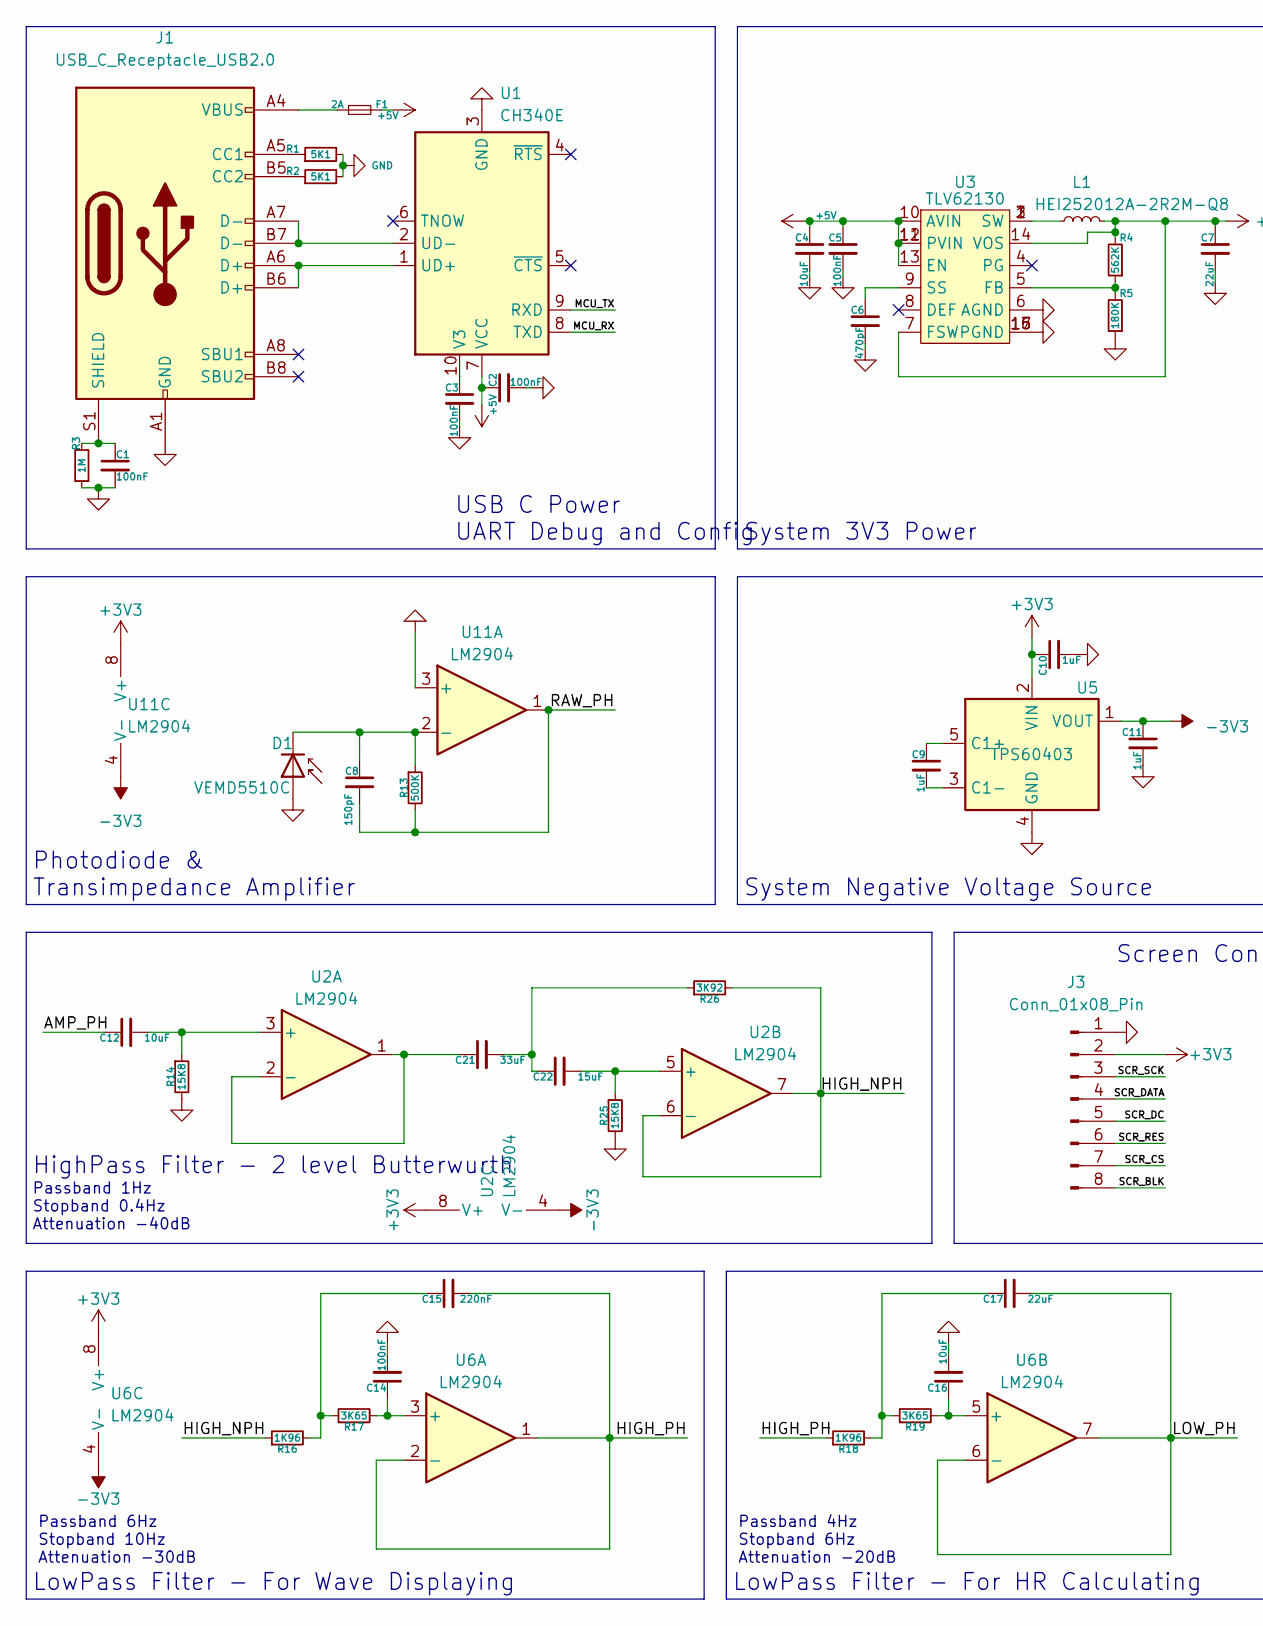
[picture p32: schematic HeartRateMonitor.kicad_sch, part in row 1, column 1]

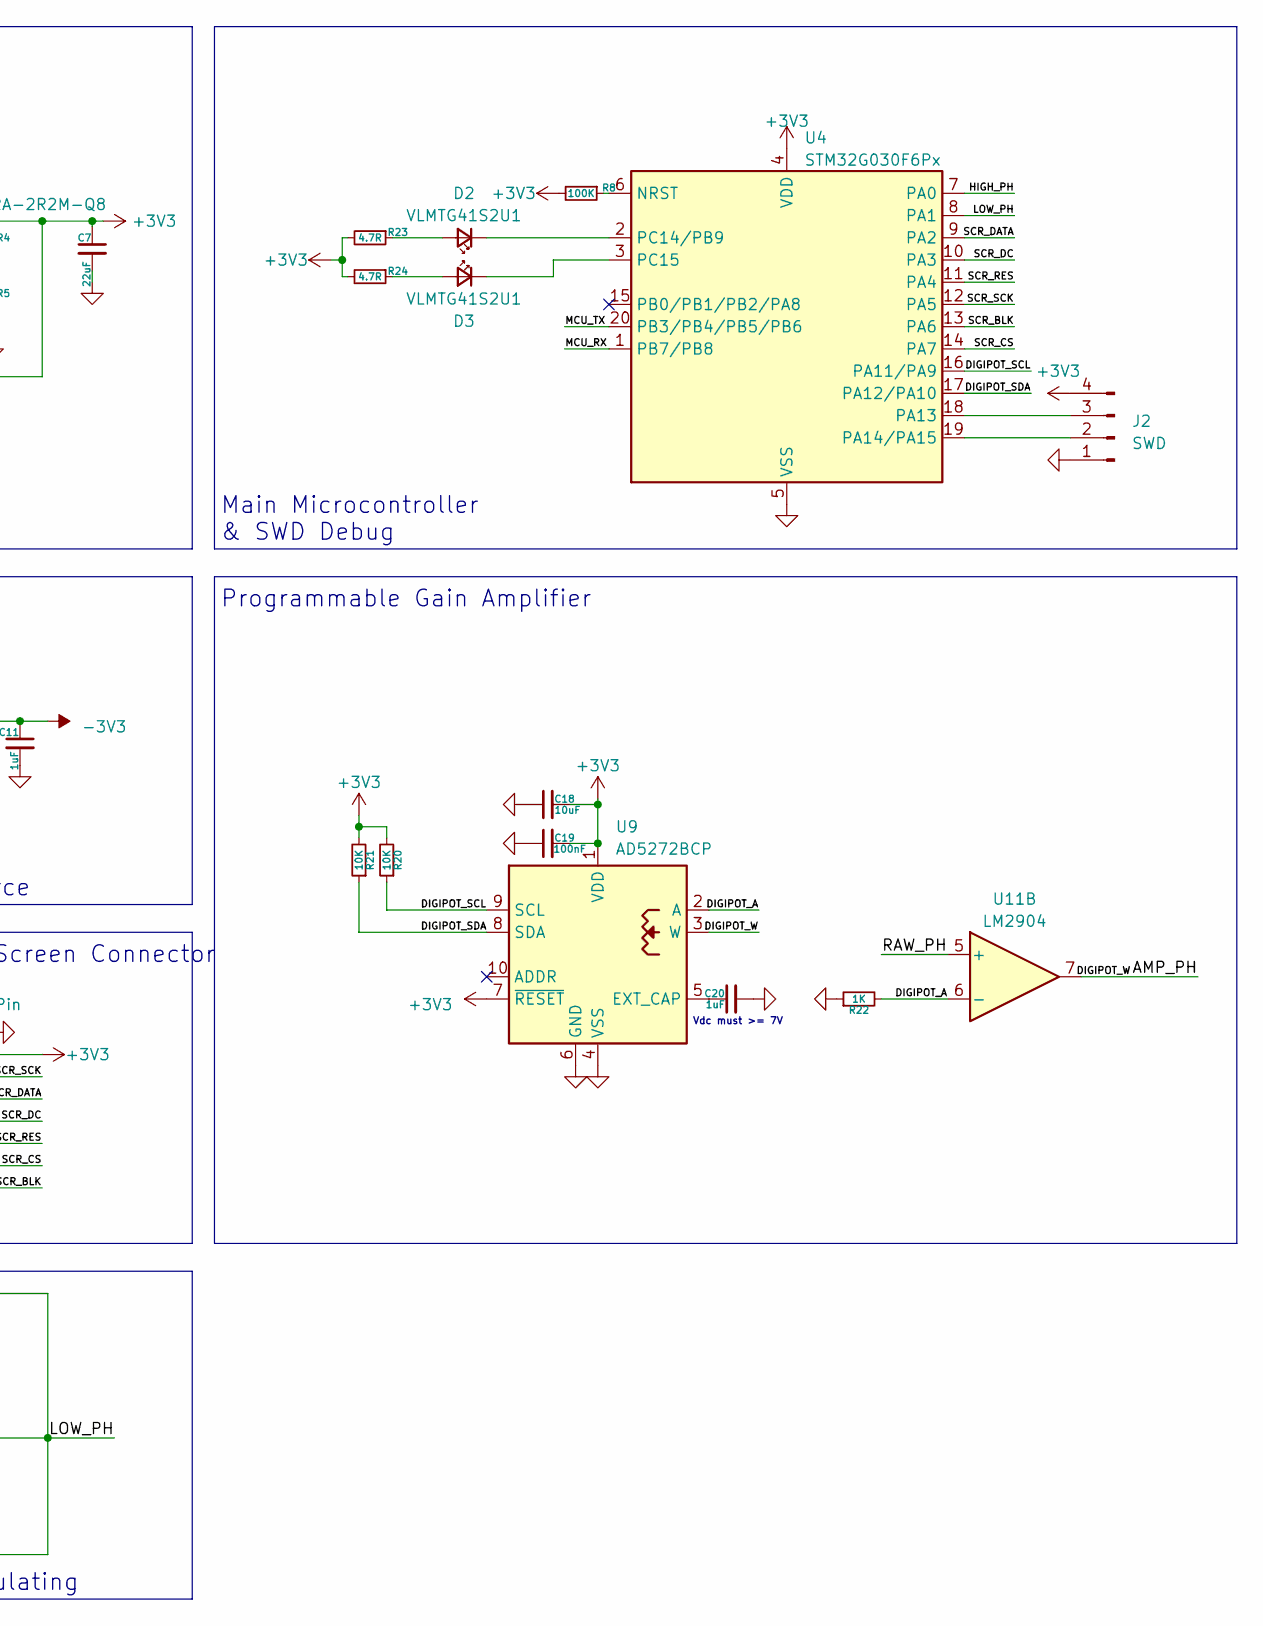
[picture p33: schematic HeartRateMonitor.kicad_sch, part in row 1, column 2]

Parts:
C1, C2, C3, C5, C14, C19: 100nF; C_0603_1608Metric
C4, C12, C16, C18: 10uF; C_0603_1608Metric
C6: 470pF; C_0603_1608Metric
C7, C17: 22uF; C_0603_1608Metric
C8: 150pF; C_0603_1608Metric
C9, C10, C11, C20: 1uF; C_0603_1608Metric
C15: 220nF; C_0603_1608Metric
C21: 33uF; C_1206_3216Metric
C22: 15uF; C_0402_1005Metric
D1: VEMD5510C
D2, D3: VLMTG41S2U1; CP_EIA-3528-21_Kemet-B
F1: 2A; Fuse_0805_2012Metric
J1: USB_C_Receptacle_USB2.0; TYPE-C-SMD_HX-TYPE-C-16PIN
J2: SWD; PinHeader_1x04_P2.54mm_Vertical
J3: Conn_01x08_Pin; PinHeader_1x08_P2.54mm_Vertical
L1: HEI252012A-2R2M-Q8; L_1008_2520Metric
R1, R2: 5K1; R_0603_1608Metric
R3: 1M; R_0603_1608Metric
R4: 562K; R_0603_1608Metric
R5: 180K; R_0603_1608Metric
R8: 100K; R_0603_1608Metric
R13: 500K; R_0603_1608Metric
R14, R25: 15K8; R_0603_1608Metric
R16, R18: 1K96; R_0603_1608Metric
R17, R19: 3K65; R_0603_1608Metric
R20, R21: 10K; R_0603_1608Metric
R22: 1K; R_0603_1608Metric
R23, R24: 4.7R; R_0603_1608Metric
R26: 3K92; R_0603_1608Metric
U1: CH340E; MSOP-10_3x3mm_P0.5mm
U2, U6, U11: LM2904; VSSOP-8_3.0x3.0mm_P0.65mm
U3: TLV62130; VQFN-16-1EP_3x3mm_P0.5mm_EP1.68x1.68mm
U4: STM32G030F6Px; TSSOP-20_4.4x6.5mm_P0.65mm
U5: TPS60403; SOT-23-5
U9: AD5272BCP; LFCSP-WD-10-1EP_3x3mm_P0.5mm_EP1.64x2.38mm

Connections:
+3V3: C7.1, C10.1, C18.2, C19.2, J2.4, J3.2, L1.2, R4.2, R8.2, R20.2, R21.2, R23.2, R24.2, U2.8 (V+), U3.7 (FSW), U3.14 (VOS), U4.4 (VDD), U5.2 (VIN), U6.8 (V+), U9.1 (VDD), U9.7 (~RESET), U11.8 (V+)
+5V: C2.1, C4.1, C5.1, F1.2, U1.7 (VCC), U3.10 (AVIN), U3.11 (PVIN), U3.12 (PVIN), U3.13 (EN)
-3V3: C11.1, U2.4 (V-), U5.1 (VOUT), U6.4 (V-), U11.4 (V-)
/AMP_PH: C12.1, U9.3 (W), U11.7
/DIGIPOT_A: R22.2, U9.2 (A), U11.6 (-)
/DIGIPOT_SCL: R20.1, U4.16 (PA11/PA9), U9.9 (SCL)
/DIGIPOT_SDA: R21.1, U4.17 (PA12/PA10), U9.8 (SDA)
/HIGH_PH: C15.2, R18.1, U4.7 (PA0), U6.1, U6.2 (-)
/LOW_PH: C17.2, U4.8 (PA1), U6.6 (-), U6.7
/MCU_RX: U1.8 (TXD), U4.1 (PB7/PB8)
/MCU_TX: U1.9 (RXD), U4.20 (PB3/PB4/PB5/PB6)
/RAW_PH: C8.2, R13.2, U11.1, U11.5 (+)
/SCR_BLK: J3.8, U4.13 (PA6)
/SCR_CS: J3.7, U4.14 (PA7)
/SCR_DATA: J3.4, U4.9 (PA2)
/SCR_DC: J3.5, U4.10 (PA3)
/SCR_RES: J3.6, U4.11 (PA4)
/SCR_SCK: J3.3, U4.12 (PA5)
GND: C1.2, C2.2, C3.2, C4.2, C5.2, C6.2, C7.2, C10.2, C11.2, C14.2, C16.2, C18.1, C19.1, C20.2, D1.2 (A), J1.A1 (GND), J1.A12 (GND), J1.B1 (GND), J1.B12 (GND), J2.1, J3.1, R1.2, R2.2, R3.1, R5.1, R14.2, R22.1, R25.2, U1.3 (GND), U3.6 (AGND), U3.15 (PGND), U3.16 (PGND), U3.17 (PGND), U4.5 (VSS), U5.4 (GND), U9.4 (VSS), U9.6 (GND), U9.11 (VSS), U11.3 (+)
unnamed: C15.1, R16.2, R17.1
unnamed: C17.1, R18.2, R19.1
unnamed: C21.2, C22.1, R26.1
unnamed: C8.1, D1.1 (K), R13.1, U11.2 (-)
unnamed: D2.2 (A), R23.1
unnamed: D2.1 (K), U4.2 (PC14/PB9)
unnamed: D3.2 (A), R24.1
unnamed: D3.1 (K), U4.3 (PC15)
unnamed: F1.1, J1.A4 (VBUS), J1.A9 (VBUS), J1.B4 (VBUS), J1.B9 (VBUS)
unnamed: J1.A5 (CC1), R1.1
unnamed: J1.B5 (CC2), R2.1
unnamed: C1.1, J1.S1 (SHIELD), R3.2
unnamed: J2.2, U4.19 (PA14/PA15)
unnamed: J2.3, U4.18 (PA13)
unnamed: L1.1, U3.1 (SW), U3.2 (SW), U3.3 (SW)
unnamed: J1.A6 (D+), J1.B6 (D+), U1.1 (UD+)
unnamed: J1.A7 (D-), J1.B7 (D-), U1.2 (UD-)
unnamed: C3.1, U1.10 (V3)
unnamed: C12.2, R14.1, U2.3 (+)
unnamed: C21.1, U2.1, U2.2 (-)
unnamed: C22.2, R25.1, U2.5 (+)
unnamed: R16.1, R26.2, U2.6 (-), U2.7
unnamed: R4.1, R5.2, U3.5 (FB)
unnamed: C6.1, U3.9 (SS)
unnamed: R8.1, U4.6 (NRST)
unnamed: C9.1, U5.5 (C1+)
unnamed: C9.2, U5.3 (C1-)
unnamed: C14.1, R17.2, U6.3 (+)
unnamed: C16.1, R19.2, U6.5 (+)
unnamed: C20.1, U9.5 (EXT_CAP)

Notes on the sheet:
System 3V3 Power
Photodiode & Transimpedance Amplifier
HighPass Filter - 2 level Butterwurth
Passband 4Hz Stopband 6Hz Attenuation -20dB
LowPass Filter - For HR Calculating
Passband 6Hz Stopband 10Hz Attenuation -30dB
Screen Connector
USB C Power UART Debug and Config
Vdc must >= 7V
Passband 1Hz Stopband 0.4Hz Attenuation -40dB
Programmable Gain Amplifier
System Negative Voltage Source
LowPass Filter - For Wave Displaying
Main Microcontroller & SWD Debug

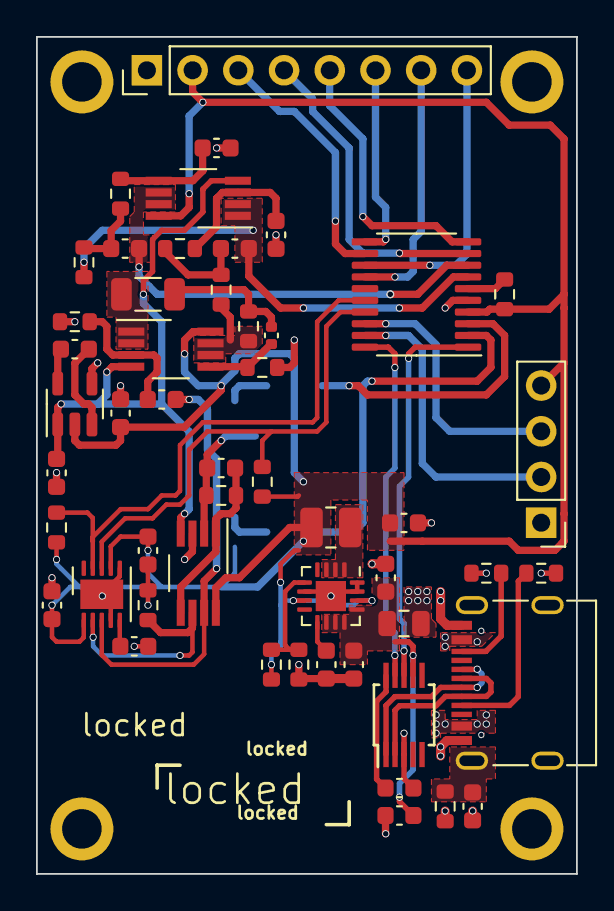
[picture p34: board HeartRateMonitor.kicad_pcb from above]

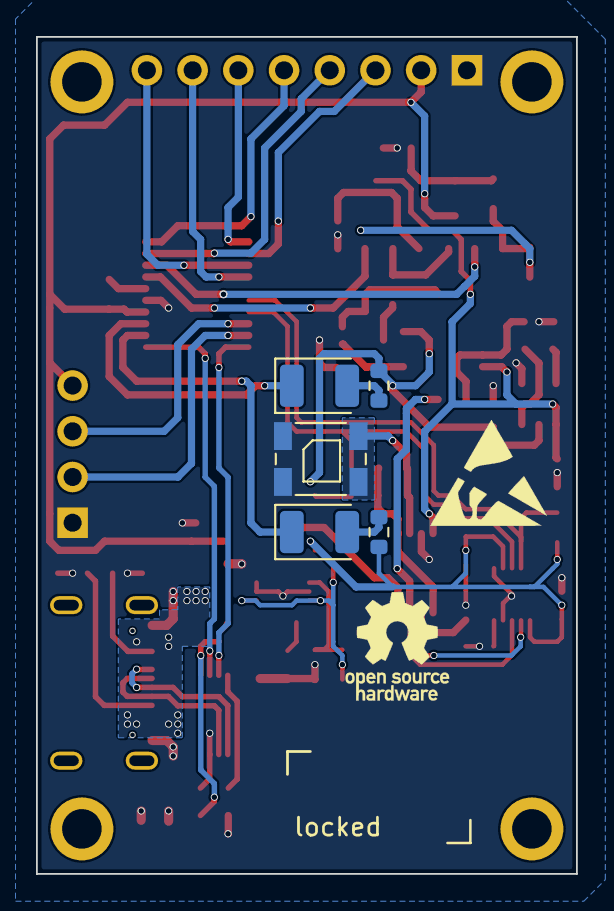
[picture p35: board HeartRateMonitor.kicad_pcb from below]

Board: 2 copper layers, 30.0 x 46.5 mm, 56 parts (5 on the bottom side), 49 nets.
