Timicasto/HeartRateMonitor/Firmware/HeartRateMonitor/Core/Src/main.cpp

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
/* Includes ------------------------------------------------------------------*/
#include "main.h"
#include "adc.h"
#include "i2c.h"
#include "tim.h"
#include "usart.h"
#include "gpio.h"
#include "beat.h"
#include "logger.h"
#include "screen.h"
#include "color.h"
#include "PGA.h"
#include "print.h"



/* USER CODE BEGIN PV */

Beat beat = Beat();

bool isConversionFinished = false;

/* USER CODE END PV */

void SystemClock_Config();
/**
  * @brief  The application entry point.
  * @retval int
  */
int main()
{
  /* MCU Configuration--------------------------------------------------------*/

  /* Reset of all peripherals, Initializes the Flash interface and the Systick. */
  HAL_Init();

  /* Configure the system clock */
  SystemClock_Config();

  /* Initialize all configured peripherals */
  MX_GPIO_Init();
  MX_USART1_UART_Init();
  MX_ADC1_Init();
  MX_I2C2_Init();
  MX_TIM3_Init();
  /* USER CODE BEGIN 2 */
	auto logger = Logger(&huart1);
	logger.log(Logger::INFO, "Logger Initialized");
	
	HAL_GPIO_WritePin(LED1_GPIO_Port, LED1_Pin, GPIO_PIN_SET);
	HAL_GPIO_WritePin(LED2_GPIO_Port, LED2_Pin, GPIO_PIN_SET);
	
	Screen screen = ScreenFactory().scl(SCREEN_SCL_GPIO_Port, SCREEN_SCL_Pin).sda(SCREEN_SDA_GPIO_Port, SCREEN_SDA_Pin).cs(SCREEN_CS_GPIO_Port, SCREEN_CS_Pin)
			.dc(SCREEN_DC_GPIO_Port, SCREEN_DC_Pin).res(SCREEN_RES_GPIO_Port, SCREEN_RES_Pin)
			.bklt(SCREEN_BLK_GPIO_Port, SCREEN_BLK_Pin).build();
	HAL_Delay(100);
	
	screen.switchBacklight(true);
	HAL_Delay(100);
	screen.fillArea( 0,  0,  32,  32, WHITE);
	screen.fillArea(32,  0,  64,  32, WHITE);
	screen.fillArea(64,  0,  96,  32, WHITE);
	screen.fillArea(96,  0, 128,  32, WHITE);
	screen.fillArea( 0, 32,  32,  64, WHITE);
	screen.fillArea(32, 32,  64,  64, WHITE);
	screen.fillArea(64, 32,  96,  64, WHITE);
	screen.fillArea(96, 32, 128,  64, WHITE);
	screen.fillArea( 0, 64,  32,  96, WHITE);
	screen.fillArea(32, 64,  64,  96, WHITE);
	screen.fillArea(64, 64,  96,  96, WHITE);
	screen.fillArea(96, 64, 128,  96, WHITE);
	screen.fillArea( 0, 96,  32, 128, WHITE);
	screen.fillArea(32, 96,  64, 128, WHITE);
	screen.fillArea(64, 96,  96, 128, WHITE);
	screen.fillArea(96, 96, 128, 128, WHITE);
	
	char str[3] = {'0', '0', '0'};
	screen.drawFont(0, 0, str, 3, WHITE, YELLOW);

	HAL_GPIO_WritePin(LED1_GPIO_Port, LED1_Pin, GPIO_PIN_RESET);
	HAL_GPIO_WritePin(LED2_GPIO_Port, LED2_Pin, GPIO_PIN_RESET);
	
	HAL_ADCEx_Calibration_Start(&hadc1);
	
	HAL_Delay(100);
	
	PGA pga(1, 20, 1024, &hi2c2, PGA::AddrMode::NC, logger);
	pga.setMagnification(20);
	
	HAL_ADC_Start_IT(&hadc1);
	HAL_TIM_Base_Start(&htim3);

  /* USER CODE END 2 */

  /* Infinite loop */
  /* USER CODE BEGIN WHILE */
	while (1)
	{
		__NOP();
		__NOP();
		if (isConversionFinished)
		{
			isConversionFinished = false;
			uint16_t val = HAL_ADC_GetValue(&hadc1);
		
			if(beat.update(val))
			{
				char buffer[11] = {0};
				Print print(buffer, 11);
				print.uint8(beat.getRate()).uint16(val).carriagereturn().newline().end();
				HAL_UART_Transmit(&huart1, reinterpret_cast<const uint8_t *>(buffer), 11, HAL_MAX_DELAY);
				screen.drawFont(0, 0, buffer, 3, WHITE, YELLOW);
			}
		}
	
    /* USER CODE END WHILE */


	// send this to screen
	
    /* USER CODE BEGIN 3 */
	}
  /* USER CODE END 3 */
}

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
