Timicasto/HeartRateMonitor/Firmware/HeartRateMonitor/HeartRateMonitor.ioc

Mcu.UserName=STM32G030F6Px
PA0.Signal=ADC1_IN0
PA1.Signal=ADC1_IN1
PA13.Signal=SYS_SWDIO
PA14-BOOT0.Signal=SYS_SWCLK
PA2.GPIO_Label=SCREEN_SDA
PA2.Signal=GPIO_Output
PA3.GPIO_Label=SCREEN_DC
PA3.Signal=GPIO_Output
PA4.GPIO_Label=SCREEN_RES
PA4.Signal=GPIO_Output
PA5.GPIO_Label=SCREEN_SCL
PA5.Signal=GPIO_Output
PA6.GPIO_Label=SCREEN_BLK
PA6.Signal=GPIO_Output
PA7.GPIO_Label=SCREEN_CS
PA7.Signal=GPIO_Output
PB6.Signal=USART1_TX
PB7.Signal=USART1_RX
