Timicasto/HeartRateMonitor/Firmware/HeartRateMonitor/Core/Inc/numfonts.h

/**
 * @file numfonts.h
 *
 * @attention
 * <h2> Copyright (C) 2023 Yao Haizhou </h2>
 *
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
 * You should have received a copy of the GNU Affero General License
 * along with this program.  If not, see <https://www.gnu.org/licenses/>.
 */

/* SPDX-License-Identifier: AGPL-3.0-or-later */

#ifndef HEARTRATEMONITOR_NUMFONTS_H
#define HEARTRATEMONITOR_NUMFONTS_H

#include "stm32g0xx.h"

const uint8_t fonts[11][60] = {

		{0xff, 0xff, 0xff, 0xff, 0xff, 0xff, 0xff, 0xff,
		 0xff, 0xff, 0xff, 0xff, 0xff, 0xff, 0xff, 0xff,
		 0xff, 0xff, 0xfc, 0x1f, 0xf0, 0x0f, 0xe0, 0x07,
		 0xc3, 0xc3, 0xc7, 0xe1, 0x87, 0xf1, 0x8f, 0xf1,
		 0x8f, 0xf1, 0x8f, 0xf1, 0x8f, 0xf1, 0x87, 0xf1,
		 0xc7, 0xe3, 0xc3, 0xc3, 0xe0, 0x07, 0xf0, 0x0f,
		 0xf8, 0x1f, 0xff, 0xff, 0xff, 0xff, 0xff, 0xff,
		 0xff, 0xff, 0xff, 0xff},
		{0xff, 0xff, 0xff, 0xff, 0xff, 0xff, 0xff, 0xff,
		 0xff, 0xff, 0xff, 0xff, 0xff, 0xff, 0xff, 0xff,
		 0xff, 0xff, 0xfe, 0x1f, 0xfc, 0x1f, 0xf8, 0x0f,
		 0xf0, 0x0f, 0xf9, 0x8f, 0xff, 0x8f, 0xff, 0x8f,
		 0xff, 0x8f, 0xff, 0x8f, 0xff, 0x8f, 0xff, 0x8f,
		 0xff, 0x8f, 0xff, 0x8f, 0xff, 0x8f, 0xff, 0x8f,
		 0xff, 0x9f, 0xff, 0xff, 0xff, 0xff, 0xff, 0xff,
		 0xff, 0xff, 0xff, 0xff},
		{0xff, 0xff, 0xff, 0xff, 0xff, 0xff, 0xff, 0xff,
		 0xff, 0xff, 0xff, 0xff, 0xff, 0xff, 0xff, 0xff,
		 0xff, 0xff, 0xfc, 0x1f, 0xf0, 0x0f, 0xe0, 0x07,
		 0xe3, 0xc3, 0xc7, 0xe3, 0xc7, 0xe3, 0xc7, 0xe3,
		 0xc3, 0xe3, 0xe3, 0xc7, 0xff, 0x07, 0xfe, 0x0f,
		 0xfc, 0x3f, 0xf0, 0x7f, 0xe0, 0x07, 0xe0, 0x03,
		 0xe0, 0x03, 0xff, 0xff, 0xff, 0xff, 0xff, 0xff,
		 0xff, 0xff, 0xff, 0xff},
		{0xff, 0xff, 0xff, 0xff, 0xff, 0xff, 0xff, 0xff,
		 0xff, 0xff, 0xff, 0xff, 0xff, 0xff, 0xff, 0xff,
		 0xff, 0xff, 0xfc, 0x1f, 0xf0, 0x0f, 0xf0, 0x07,
		 0xe3, 0xc7, 0xff, 0xc7, 0xff, 0xc7, 0xfe, 0x07,
		 0xfe, 0x0f, 0xfe, 0x07, 0xff, 0xc3, 0xff, 0xe3,
		 0xff, 0xe3, 0xe3, 0xe3, 0xe0, 0x07, 0xf0, 0x07,
		 0xf8, 0x1f, 0xff, 0xff, 0xff, 0xff, 0xff, 0xff,
		 0xff, 0xff, 0xff, 0xff},
		{0xff, 0xff, 0xff, 0xff, 0xff, 0xff, 0xff, 0xff,
		 0xff, 0xff, 0xff, 0xff, 0xff, 0xff, 0xff, 0xff,
		 0xff, 0xff, 0xff, 0x3f, 0xfe, 0x3f, 0xfe, 0x3f,
		 0xfc, 0x7f, 0xf8, 0x7f, 0xf8, 0xff, 0xf1, 0xff,
		 0xe1, 0x1f, 0xe3, 0x1f, 0xc0, 0x03, 0xc0, 0x03,
		 0xc0, 0x03, 0xff, 0x1f, 0xff, 0x1f, 0xff, 0x1f,
		 0xff, 0x1f, 0xff, 0xff, 0xff, 0xff, 0xff, 0xff,
		 0xff, 0xff, 0xff, 0xff},
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
};

#endif //HEARTRATEMONITOR_NUMFONTS_H
