Timicasto/HeartRateMonitor/(commit log)

2023-04-16 firmware template and PCB constrains
    [HeartRateMonitor.kicad_pcb, HeartRateMonitor.kicad_sch]
2023-04-19 add TIA
    [HeartRateMonitor.kicad_sch]
2023-04-19 low and high pass filter
    [HeartRateMonitor.kicad_pcb, HeartRateMonitor.kicad_sch]
2023-04-22 modify latout
    [HeartRateMonitor.kicad_pcb]
2023-04-22 add LED
    [HeartRateMonitor.kicad_pcb, HeartRateMonitor.kicad_sch]
2023-04-23 slight modify layout
    [HeartRateMonitor.kicad_pcb]
2023-04-24 success 1/2 (?)
    [HeartRateMonitor.kicad_pcb]
2023-04-24 0.9 (?)
    [HeartRateMonitor.kicad_pcb]
2023-04-24 completed, left DRC unchecked
    [HeartRateMonitor.kicad_pcb]
2023-04-27 ADC DMA Timer
2023-04-28 slightly modified filter and generated fabrication output
    [HeartRateMonitor-B_Cu.gbr, HeartRateMonitor-B_Mask.gbr, HeartRateMonitor-B_Paste.gbr, HeartRateMonitor-B_Silkscreen.gbr, HeartRateMonitor-Edge_Cuts.gbr, HeartRateMonitor-F_Cu.gbr, HeartRateMonitor-F_Mask.gbr, HeartRateMonitor-F_Paste.gbr]
2023-05-04 finalize hardware
    [HeartRateMonitor-B_Cu.gbr, HeartRateMonitor-B_Mask.gbr, HeartRateMonitor-B_Paste.gbr, HeartRateMonitor-B_Silkscreen.gbr, HeartRateMonitor-Edge_Cuts.gbr, HeartRateMonitor-F_Cu.gbr, HeartRateMonitor-F_Mask.gbr, HeartRateMonitor-F_Paste.gbr]
2023-05-14 LCD Device Driver and Migrated to Makefile
    [HeartRateMonitor-B_Cu.gbr, HeartRateMonitor-B_Mask.gbr, HeartRateMonitor-B_Paste.gbr, HeartRateMonitor-B_Silkscreen.gbr, HeartRateMonitor-Edge_Cuts.gbr, HeartRateMonitor-F_Cu.gbr, HeartRateMonitor-F_Mask.gbr, HeartRateMonitor-F_Paste.gbr]
2023-05-17 Changed SPI configuration (8MBit/s LSB First)
2023-05-19 ADC conversion IT via UART
2023-05-19 open led
2023-05-20 add print lib
2023-05-20 add shell
    [shell-PartBody.stl, shell-PartCap.stl, shell.FCStd]
2023-05-20 complete print
2023-05-22 Fix: AD5272 I2C Timing
    [HeartRateMonitor.ioc]
2023-05-24 modify spi rate
2023-05-24 try to fix screen,failed
    [screen.cpp, screen.h]
2023-05-24 Feat: Migrated Beat rate algorithm into ADC IT
2023-05-25 fix print
2023-05-25 changed timer config method
2023-05-25 fix timer
2023-05-25 try to fix beat
    [beat.cpp, beat.h]
2023-05-26 changed to software emulated SPI
2023-05-26 fix area size calculation
    [screen.cpp]
2023-05-26 Fix init in main
    [main.cpp]
2023-05-30 Report: 6 - Power test
2023-05-31 Hardware Cleanup
    [HeartRateMonitor-B_Cu.gbr, HeartRateMonitor-B_Mask.gbr, HeartRateMonitor-B_Paste.gbr, HeartRateMonitor-B_Silkscreen.gbr, HeartRateMonitor-Edge_Cuts.gbr, HeartRateMonitor-F_Cu.gbr, HeartRateMonitor-F_Mask.gbr, HeartRateMonitor-F_Paste.gbr]
2023-05-31 Fix PCB Layout PDF
2023-05-31 Report - Appendix
    [HeartRateMonitor.csv, HeartRateMonitor.kicad_pcb]
