Timicasto/HeartRateMonitor/(notices)

Notices in the files:
Firmware/HeartRateMonitor/Core/Src/screen.cpp:
This program is free software: you can redistribute it and/or modify
it under the terms of the GNU Affero General License as
published by the Free Software Foundation, either version 3 of the
License, or (at your option) any later version.
Firmware/HeartRateMonitor/Core/Src/gpio.c:
Copyright (c) 2023 STMicroelectronics.
All rights reserved.
This software is licensed under terms that can be found in the LICENSE file
Firmware/HeartRateMonitor/Core/Inc/main.h:
© Copyright (c) 2023 STMicroelectronics.
This software component is licensed by ST under BSD 3-Clause license,
the "License"; You may not use this file except in compliance with the
License. You may obtain a copy of the License at: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
